dxoverdy/Alpha2MQTT/(threads)

Thread 1 (2022-09-13):

ESP32 support

mercurystorm, 2022-09-13:
I love the idea of this and looking to build my own - Do you know if this would work on an ESP32 instead of an ESP8266?

Benefit being that the ESP32 is much more powerful

dxoverdy, 2022-09-13:
This is a Wemos D1 ESP8266 vs D1 ESP32 circuit layout.
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

Instead of adding
http://arduino.esp8266.com/stable/package_esp8266com_index.json
to your Arduino Board Manager URLs, you'd add
https://dl.espressif.com/dl/package_esp32_index.json

And in Board Manager, search out esp32 to install appropriate libraries for the ESP32 Dev module, WEMOS LoLin32 or WEMOS D1 MINI ESP32.

To get the code to compile will involve changing WiFi8266.h to WiFi.h and SoftwareSerial.h to HardwareSerial.h and utilising pins such as IO18, IO19 and IO23 instead of D5, D6 and D7 respectively, seeing as the ESP32 has more than one hardware based serial port.

Let me source one, I'll tweak the code and either create a fork or see if there is a way to #define it to death.  Unless you fancy being a remote tester with my attempts? :)

mercurystorm, 2022-09-13:
Happy to be a remote tester, I already have an ESP32 lying around in the draw, and have ordered the other parts off amazon, but they will take a day or 3 to arrive (Ireland)

mercurystorm, 2023-04-11:
Just as an update on this - I finally ordered a MAX3485 and decided to play around with the ESP32 to see if I could get it working - If anyone else plans to use an ESP32 these are the changes I made

**Alpha2MQTT.ino**
Changed Line 19
`#include <ESP8266WiFi.h>`

to

`#include <WiFi.h>`

************************************

**Definitions.h**
Added Line 13
`#define LED_BUILTIN 2`

************************************

**RS485Handler.h**
Changed the following pin assignments

`#define SERIAL_COMMUNICATION_CONTROL_PIN D5	// Transmission set pin
#define RX_PIN D6							// Serial Receive pin
#define TX_PIN D7							// Serial Transmit pin`

to

`#define SERIAL_COMMUNICATION_CONTROL_PIN 18	// Transmission set pin
#define RX_PIN 19							// Serial Receive pin
#define TX_PIN 23							// Serial Transmit pin`

Added Package: **ESPSoftwareSerial**

dan-s-github, 2023-06-11:
I ordered a m5stack ATOM RS485 Kit https://shop.m5stack.com/products/atom-rs485-kit and also an atom s3 that includes the display and should look pretty neat and doesn't require an additional power supply.

will try to build and install using the comments above

https://docs.m5stack.com/en/atom/atomic485

RX_PIN 22
TX_PIN 19

dxoverdy, 2023-07-23:
ESP32 support now added.  Please see instructions in 1.21 and 1.22.  With regards, Dan.

Closed 2023-07-23.

Thread 2 (2022-09-27):

Ground?

jt1971, 2022-09-27:
Good morning.  I was delighted to find this having recently taken delivery of a Smile5 inverter.
Just waiting for all the components to arrive to set up as per your excellent notes.
Can I just confirm from the diagram you don't have a ground connection specifically to the RJ45 connector? Not sure which are the ground wires used by the Alpha and my electronics knowledge is not as advanced!

Thanks.

dxoverdy, 2022-09-27:
Ground (as in next to A+/B-) on the MAX3845 isn’t required.  It’s if you
have outer shielding on your cable as opposed to leveraging twisted pair
which is inherently shielded via the twists.

As the Smile is an RJ45 with twisted pair it’s shielded already, and likely
no pin on the Alpha is a ground anyway.

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

jt1971, 2022-10-02:
Thanks.

Al installed and working perfectly on my Smile5 (just waiting batteries).  Can I congratulate you on really clear and helpful instructions, both the code and the wiring. Can I get you a virtual coffee?!

dxoverdy, 2022-10-03:
That's really kind, and I am really glad you went ahead and built it and had success!  I didn't have anything set up by way of ko-fi, it wasn't the main driving force...  But, I have done so and set up the sponsor link to ko-fi on the right hand side of the Alpha2MQTT repository homepage :)  Thanks again.

If you have any pictures of your build in situ with your inverter I've love to see them and put on the gallery.

Finally, could I ask which pins ended up being A+/B- on the Smile 5 for the documentation?

jt1971, 2022-10-18:
Hi there,

Apologies for the delay, but have been waiting for the batteries to be installed before I sent though a picture.

Thanks again,

Justin
￼￼

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

JohnnyZeta, 2022-11-04:
Hi jt1971! I also have a SMILE5 inverter, and I'm struggling to find a ModBus response from the RJ45 plugs on the device.
I tried every couple of wire (white blue/blue, white green/green and so on) on every RJ45 port that seems possible (I tried INV, LAN, CAN), but still no response.

My model is [this one](https://alpha-ess.co.nz/wp-content/uploads/2021/02/Installation-Manual-Storion-Smile-5-V2.pdf).

How do you connected yours?

Thank You in advance!

danielyoung1000, 2022-11-04:
On Page 51 of your manual there, ensure 'Modbus' is enabled on your device.  In the modbus documentation (pic below) it also says "LAN2 or CAN - Modbus must be activated in the display"
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

In effect, it's the most right hand port.

I believe it is the same two pins as my B3 - blue white and blue.  Blue white to +.

dxoverdy, 2022-11-04:
Bah, was signed in with my work account.  Let me know how you get on.

dxoverdy, 2022-11-04:
Any pictures of your working device would be gratefully received.  I'd love to see other people's efforts!

ffrog8, 2022-11-11:
@JohnnyZeta I think I'm having similar issues with my smile5. Could you confirm you inverted RX-TX pair on the D1 - do you mean you switched the D1 mini's pins D6 and D7?

dxoverdy, 2022-11-11:
I suspect @JohnnyZeta put D6 to Rx and D7 to Tx, instead of the other way round.

ffrog8, 2022-11-11:
Ahhh okay. @JohnnyZeta did you have to enable modbus in your inverter settings? I don't even seem to have that setting. Thanks.

JohnnyZeta, 2022-11-11:
Hi @ffrog8!
Yes, I inverted D6 and D7, so that was my error.

I enabled slave modbus mode in the inverter's settings; you should found it under Menu -> Setting (1111 default password) -> Function -> Modbus. I also restarted the inverter, but I don't know if is needed/relevant.

ffrog8, 2022-11-11:
Cheers mate. I dunno if its a firmware difference or set up difference but i have no Modbus (or parallel) option in my Function sub menu. I'm running EMS 1.02.41, BMS 1.02 and Invert version 01.97 - how does that compare to your versions? Set up wise I have the smile 5 with 6.6kw of panels and the 13kwh battery - hybrid i think they call it.

Closed 2022-11-22.

Thread 3 (2022-11-22):

Which register for Alpha5 PV array

jt1971, 2022-11-22:
Hi. I know this will seem a bizarre question, but I cannot actually find the register that relates to the two DC connected PV arrays on my Smile5.

REG_PV_METER_R_TOTAL_ACTIVE_POWER_1 reports values for my AC coupled separate solax inverter through a 2nd ACR10R meter.

The only way which does seem odd, is for me to sum the output of REG_INVERTER_HOME_R_PV1_POWER_1 + REG_INVERTER_HOME_R_PV1_POWER_2 and multiply by 10, which approximates to the instantaneous PV output as displayed on the inverter screen itself.

I'm sure I'm missing something, but having looked through all the registers, I cannot find a register that reflects the PV output from the arrays that are connected directly to the inverter.

Thanks.

SorX14, 2022-11-23:
https://github.com/dxoverdy/Alpha2MQTT/blob/master/Alpha2MQTT/RegisterHandler.cpp#L3102 looks to be dividing by 10 incorrectly, i.e. `REG_INVERTER_HOME_R_PV1_POWER_X` registers are giving values that are 10 times less than what it should be.

Those two registers are for the strings of panels connected to the SMILE5, at least they are for me. They match the readings available from the AlphaESS Cloud dashboard (if you check the XHR requests).

dxoverdy, 2022-11-23:
The registers which consist of a _1 and _2 at the end are in fact the same register but a lower and upper end because the number is potentially so large it needs two registers to store it in its entirety.  In the code I’ve commented out the _2s because reading handled registers (ie what gets spat out in a repeating state) does all the hard work of combining the two in the correct way.  What you added there were the two component parts of one array and multiplied and out of chance it got somewhere near.

You want to expose these in one of your repeating states, presumably the 10 second one:

REG_INVERTER_HOME_R_PV1_POWER_1
REG_INVERTER_HOME_R_PV2_POWER_1
REG_INVERTER_HOME_R_PV3_POWER_1

etc etc.  And add those together to get total DC input.

P.S. what’s the use case?  I understand individuals for plotting charts for east/west arrays for example.

dxoverdy, 2022-11-23:
> https://github.com/dxoverdy/Alpha2MQTT/blob/master/Alpha2MQTT/RegisterHandler.cpp#L3102 looks to be dividing by 10 incorrectly, i.e. `REG_INVERTER_HOME_R_PV1_POWER_X` registers are giving values that are 10 times less than what it should be.
>
> Those two registers are for the strings of panels connected to the SMILE5, at least they are for me. They match the readings available from the AlphaESS Cloud dashboard (if you check the XHR requests).

Noted and correct.  Will modify and upload later.  The joy of copy and pasting!

dxoverdy, 2022-11-23:
Amended to remove the 0.1 mulitplication.  Let us know how you get on summing up the appropriate number of
REG_INVERTER_HOME_R_PV1_POWER_1
REG_INVERTER_HOME_R_PV2_POWER_1
REG_INVERTER_HOME_R_PV3_POWER_1
and if good, close the issue.

Thanks very much
Dan

jt1971, 2022-11-26:
Perfect.  Only just been able to update and test.  Thanks. PV1+PV2 now exactly mirrors the Smile5 display.

Closed 2022-11-26.

Thread 5 (2023-01-07):

Does alphaess support master -slave configuring?

Saadi246, 2023-01-07:
Does alphaess support master and slave?
Please share sum details

dxoverdy, 2023-01-14:
No, the Alpha is a slave device, which can be driven by one master ala Alpha2MQTT or their EV WallBox charger.

Closed 2023-01-14.

Thread 6 (2023-02-28):

Discharge mode

jt1971, 2023-02-28:
Hi. I've been really impressed with the alpha2mqtt, both hardware and the software. I have mine connected to HA and have therefore used your excellent yaml code for the mqtt and the controls.  Everything is working fine other than:
1. With the exception of the charge mode, 'Dispatch mode' always states 'unknown' (the ModBus arduino code is reporting 'unknown'
2. If I try to select discharge mode (to dump excess battery charge into the car for example), although the response status says 'setDischargeStatus' and and '0' for failure detail, the dispatch power does not budge from 32000W and other parameters in the Information entity box remain unchanged.

I'm not entirely sure how I can diagnose further.  HA is sending out the correct mqtt message as far as I can tell (using MQTT explorer on my Mac).

Apologies if a bit of a lame question, but I'm not sure how to progress to resolve this?

Thanks!

ettiennecoetzee, 2024-01-06:
Hi, mine says the same. What inverter do you have?

ettiennecoetzee, 2024-01-08:
My discharge mode on the Smile G3S5 is also not working. I set the target soc and max dc wattage and 2 hour time span, but no discharge. Let me know if I can share specific details so that you can trouble shoot? @dxoverdy

dxoverdy, 2024-01-08:
I’ve no idea what could be causing this as the steps are the same.  But I’m
thinking it may be down to the current regulation set in the system.

Can you read out regulation please and let me know what it is?

On Mon, 8 Jan 2024 at 13:33, Ettienne Coetzee ***@***.***>
wrote:

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

dxoverdy, 2024-01-08:
Read out via handled register 0x1000

#define REG_SAFETY_TEST_RW_GRID_REGULATION 0x1000

I’m wondering if your inverter is set to a grid regulation which doesn’t
currently (or suggests) it doesn’t allow discharge.

Please let me know the return value and description.  Mine for example is
16 / G99

On Mon, 8 Jan 2024 at 15:52, Ettienne Coetzee ***@***.***>
wrote:

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

ettiennecoetzee, 2024-01-08:
Data value: 10
Formatted: NRS097-2-1
Function code:3
Raw data: [0,10]

dxoverdy, 2024-01-08:
Send four separate MQTT messages to this topic:
Alpha2MQTT/request/write/register/raw/data

-- Dispatch Start
`{
    "registerAddress": "0x0880",
    "dataBytes": 2,
    "value": 1
}`

-- Power (1000W discharge)
`{
    "registerAddress": "0x0881",
    "dataBytes": 4,
    "value": 33000
}`

-- Time (Just two 2 minutes)
`{
    "registerAddress": "0x0887",
    "dataBytes": 4,
    "value": 120
}`

-- SOC (down to 15%) 15 / 0.4 = 37.5, so 38 will do
{
    "registerAddress": "0x0886",
    "dataBytes": 2,
    "value": 38
}

-- Mode - SOC Control (2)
`{
    "registerAddress": "0x0885",
    "dataBytes": 2,
    "value": 2
}`

You don't have to rush them.  Allow a few seconds before each, allowing plenty of time for copy and paste.  I am wondering if pinging the four steps required to activate discharge (Start Dispatch, Set Power, Set Duration, Set Minimum SOC and Set Mode) if issued separately works.  If it does that would suggest when Alpha2MQTT sends the messages, it is sending them all too quickly.

ettiennecoetzee, 2024-01-08:
Done. No discharge.

This is what my Alpha Control Dash looks like:
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

dxoverdy, 2024-01-08:
Whoahh that percentage needs a bit of work.  What is your battery
percentage currently (proper) and why is battery power zero?

On Mon, 8 Jan 2024 at 18:20, Ettienne Coetzee ***@***.***>
wrote:

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

dxoverdy, 2024-01-08:
Does the same set of commands, albeit with 31000 power start charging at
1000W?

On Mon, 8 Jan 2024 at 18:20, Ettienne Coetzee ***@***.***>
wrote:

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

ettiennecoetzee, 2024-01-09:
Battery percentage was 90%. I think the power was zero since it wasnt charging or discharging.
I changed the 33000 to 1000. This is what happened:
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

dxoverdy, 2024-01-09:
Any idea why the battery is not either discharging or charging?

On Tue, 9 Jan 2024 at 07:13, Ettienne Coetzee ***@***.***>
wrote:

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

dxoverdy, 2024-01-09:
Either way the percentage reading is unexpected.  Whilst it may not be to
blame it doesn’t fill me with confidence anyway.

If you want to do what others have done, ping me a private message with
details to access your home assistant instance (preferably a separate
account for me so you can disable it after) and I’ll have a Quick Look
around.

On Tue, 9 Jan 2024 at 07:13, Ettienne Coetzee ***@***.***>
wrote:

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

jt1971, 2024-01-09:
As an aside, my target soc has always shown spurious figures but still works great on my Smile5.Sent from my iPhone.On 9 Jan 2024, at 07:27, Daniel Young ***@***.***> wrote:
Either way the percentage reading is unexpected.  Whilst it may not be to

blame it doesn’t fill me with confidence anyway.

If you want to do what others have done, ping me a private message with

details to access your home assistant instance (preferably a separate

account for me so you can disable it after) and I’ll have a Quick Look

around.

On Tue, 9 Jan 2024 at 07:13, Ettienne Coetzee ***@***.***>

wrote:

> But it still won't discharge

>

> —

> Reply to this email directly, view it on GitHub

> <https://github.com/dxoverdy/Alpha2MQTT/issues/6#issuecomment-1882523074>,

> or unsubscribe

> <https://github.com/notifications/unsubscribe-auth/AZC7OYIF52KXQWCCNLG5AFTYNTU2NAVCNFSM6AAAAAAVK5DXOCVHI2DSMVQWIX3LMV43OSLTON2WKQ3PNVWWK3TUHMYTQOBSGUZDGMBXGQ>

> .

> You are receiving this because you were mentioned.Message ID:

> ***@***.***>

>

—Reply to this email directly, view it on GitHub, or unsubscribe.You are receiving this because you authored the thread.Message ID: ***@***.***>

dxoverdy, 2024-01-09:
So it looks like that safety regulation may prevent discharge from battery
to grid.  After all, the code to charge is the same code to discharge, one
just uses a number above 32000 and the other uses one below.  I can see the
other fella in this chat now discharges fine so not sure what he’s done to
get it working….

Perhaps mail alpha and ask if your regulation prevents discharge.

(You can always change it to something we know such as G99 to try)

Good luck!

On Tue, 9 Jan 2024 at 14:06, Ettienne Coetzee ***@***.***>
wrote:

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

ettiennecoetzee, 2024-01-10:
Sorry for bugging you again. Just a quick question. I want to try and set my 0x1000 register to your value (G99). This might be a dumb question, but how do I go about this? When I currently read my raw register, it looks like this:
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
What should I enter in my Alpha Control dash to change it to yours, and also, if I want to change it back?
Thanks!

dxoverdy, 2024-01-10:
Like so:

#define GRID_REGULATION_AL_10 10
#define GRID_REGULATION_AL_10_DESC "NRS097-2-1"
which is why yours currently returns raw data 0,10
#define GRID_REGULATION_AL_16 16
#define GRID_REGULATION_AL_16_DESC "G99"

`Alpha2MQTT/request/write/register/raw/data`

Set to G99
`{
    "registerAddress": "0x1000",
    "dataBytes": 2,
    "value": 16
}`

Set to NRS097-2-1
`{
    "registerAddress": "0x1000",
    "dataBytes": 2,
    "value": 10
}`

Closed 2024-01-22.

Thread 8 (2023-05-15):

Set charge / discharge times?

Spookster, 2023-05-15:
*Havent installed yet
Before I dive in, is there a documented way to set discharge / charge times from the interface via code example? (Home Assistant)
Im running a SMILE5 and the documentation and HA Dashboards youve provided doesnt seem to cover that specifically (although it would be possible)

Does anyone have a HA example? or did I miss it?

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

dxoverdy, 2023-05-15:
The registers here (
https://github.com/dxoverdy/Alpha2MQTT/blob/4966f1f971f7648a23bdbb75225ca94c7a37ab1e/Alpha2MQTT/Definitions.h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)
write those settings.

For example, writing 1 to  REG_TIMING_RW_TIME_CHARGE_START_TIME_1
Will set a start charge time of 00:01.

Alternatively, you can set charge or discharge via an mqtt message.

Dan

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

Spookster, 2023-05-15:
So theres nothing in the Alpha Write Register HA pages that specifically set it? (ie no dashboard pages that people have created specifically for that control?)
Ill delve in deeper once its running
Thanks Dan, your work seems like just what I want.. let the fun begin.....

Spookster, 2023-05-16:
So this would give a time of 0.01?

```
service: mqtt.publish
data:
  retain: false
  topic: Alpha2MQTT/request/write/register/raw/data
  payload:
    registerAddress: "0x0851"
    value: 1
    dataBytes: 2
  qos: "0"
```
And this 2300?
```
service: mqtt.publish
data:
  retain: false
  topic: Alpha2MQTT/request/write/register/raw/data
  payload:
    registerAddress: "0x0851"
    value: 2300
    dataBytes: 2
  qos: "0"
```

dxoverdy, 2023-05-16:
There is a dashboard which lets you specify a register address and a value
and it will write it.  It’s called Alpha Inverter Control or something like
that.

If you read the docs I’m sure the charge discharge times are set as
minutes, so 0 would be midnight, 1439 would be 23:59 (60*23)+59.  Although
they were the first registers I played with when it comes to writing I just
can’t remember.  What I’d do is write 0 and see what happens, then 10, then
60, etc….

Regarding payloads, download mqttexplorer and do your initial testing
through that.  It’s an invaluable tool.

What is your intention here can I ask?

Dan

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

Spookster, 2023-05-16:
Nothing too specific I guess, currently using Charles Gillanders code to switch to mains power to run a heat pump when temperatures drop early morning to preserve the battery for use during the day.
Normally the battery is set to discharge mode, but for that case, run it on mains and then switch back to battery
The only reason I switch to mains is to make use of the power credits I have accumulated :)

Other case use would be for variable 'free hours' various wholesalers offer here. (You can select on a daily basis which hour is free)
I currently get a fixed 3 hrs free between 9pm and 12, so it doesnt really effect mine. Thats the fixed battery charge time.

jt1971, 2023-05-16:
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

My code is scrappy but works well using timed automations to send the mqttt messages using the brilliantly engineered alpha2mqtt work.  Have got it to the point that it works semi-autonomously including managing charge/discharge with/without EV maximising benefit from Octopus Flux tariff.

It is too scrappy to share but happy to share the principles I used in HA?

Spookster, 2023-05-17:
> It is too scrappy to share but happy to share the principles I used in HA?

Id be happy to see what you have done to give some ideas?

DannyBoy-PI, 2023-09-19:
My AlphaESS SMILE B3 can have 15, 30 & 45 minutes set for charge/discharge times. I have modified the Definitions.h, RegisterHandler.cpp and Alpha2MQTT.ino to include the new registry hex values for this, but the values for minutes always report zero. Any ideas as to what may be wrong (I followed the AlphaESS_Register_Parameter_List.pdf and ensured I have set the correct values (0x085E, 0x085F, 0x0860 & 0x0861)) ? Great project and far more reliable than trying to pull data from the Alpha Cloud.
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

spiderdijon, 2024-04-09:
I have also noticed 0x085E, 0x085F, 0x0860 & 0x0861 appear to be always 0 even when set to 15,30,45 minutes in the app. Has anyone managed to set the minute registers successfully?

DannyBoy-PI, 2024-04-09:
No, I haven't been able to get this to work. I contacted AlphaESS and they "claim" it is not supported on the B3. I set the times using the webpage and disconnected my B3 from the net and it charged at the specified time (10:15 -> 10:30 I seem to recall), so it does action the request locally (not a push from AlphaESS), I just have not found out where it is stored in the registry of the B3.....

dxoverdy, 2024-04-09:
They were the first registers I wrote to as a test as they were pretty safe.
I found you could burn any time you wanted:

First Start Time Charge -- 00:30
{"registerAddress": "0x0856","value":30,"dataBytes":2}
First Stop Time Charge -- 04:30
{"registerAddress": "0x0857","value":270,"dataBytes":2}
Second Start Time Charge -- 17:51
{"registerAddress": "0x0858","value":1071,"dataBytes":2}
Second Stop Time Charge -- 18:42
{"registerAddress": "0x0859","value":1122,"dataBytes":2}

Just multiply 60 by the number of hours and add on the remaining minutes.  17:51 and 18:42 will appear on the web site, but I couldn't tell you if the inverter honours is.  Sticking to 15 minutes at the very least will.

DannyBoy-PI, 2024-04-10:
Interesting, I tried to set it for 02:15 (60 x 2 + 15) = 135 using the following:-
mosquitto_pub -h <servername> -p 1883 -t Alpha2MQTT/request/write/register/raw/data -m '{"registerAddress":"0x0856","dataBytes":2,"value":135}'
And it has set the charge start time for 15:00 ? Am I being a bit dim ?

dxoverdy, 2024-04-10:
That’s weird.  That suggests every 1 is worth 6.666 minutes.

What does it change to if you just burn the value 1?

Also, don’t forget, with your alpha2mqtt you can ping a four hour charge
message manually at 2:15 if you are seeking to make use of a car tariff.

Regards
Dan

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

DannyBoy-PI, 2024-04-10:
Hi Dan,
Sending value 1 sets it to 01:00.
As for the reason behind me wanting this: On Intelligent Octopus Go, you get cheap rates during the day (if charging your car) if the weather is windy enough. I'm knocking up code to detect this and then making use of it to charge my Alpha Batts (and change the unit rate in my app) if I need too...
Cheers,
Dan M.

DannyBoy-PI, 2024-04-10:
Even weirder, setting it to 130 changes the start time to 10:00 ????

dxoverdy, 2024-04-10:
I think that makes sense.  If you work on the assumption that 1 is an hour,
5 days is 120 hours and you’re back at midnight.  The remaining 10 gets you
to ten am.

How about 0.25?

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

DannyBoy-PI, 2024-04-10:
sending 0.25 gives me a start time of 01:00

DannyBoy-PI, 2024-04-10:
Interesting, sending 0.50 gives me a start time of 02:00

DannyBoy-PI, 2024-04-10:
and 0.75 gives me 03:00, so I tried 0.80 and I got 08:00 !!, so I tried 1.25 and got 05:00..........

DannyBoy-PI, 2024-05-16:
Hi Dan,
Thanks for the above, but that is what I was originally trying to do before my first post to this group. I will try again though and see if it makes any difference...

DannyBoy-PI, 2024-05-16:
Hi again Dan,
Just tried the following:-

mosquitto_pub -h <server_name> -p 1883 -t Alpha2MQTT/request/write/register/raw/data -m '{"registerAddress":"0x085E","dataBytes":2,"value":25}'

And the value for minutes remains unchanged on the website/app - Do you have a legacy Smile B3 and have you tried the same ?

Cheers,

Dan M.

dxoverdy, 2024-05-16:
I have a B3 basic and Alpha told me it would never support any new features
such as the more granular time, or the discharge to grid via app, or modbus
TCP.

They’ve moved on from it unfortunately, harsh seeing as I dropped 4k on an
11kWh system but times move on.

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

DannyBoy-PI, 2024-05-16:
Hi Dan,

Yeah, it's odd that it supports it via the app/web (i.e. 00,15,30,45 minutes), yet it doesn't use those registers. I've proved it's not a push at the specific time from Alpha as I disconnected my system from the net and it started charging at the time I set.. So... It must be storing it somewhere in the registry, I just don't know where. I was considering knocking up a bit of code to collect all the registry data, then make the change (to say 02:45), collect the all the registry data again, and then check for differences...I will give this a go at some point, but busy with other things right now...

Thanks anyway, your code/hardware does just about everything else I need and is far superior to API's.

It is a shame that Alpha can't be bothered to support the legacy systems that have at least 4 or 5 years of life left to them. It would certainly make me think before purchasing a new Alpha system in the future, which is a shame as the hardware is good !

Dan M.

dxoverdy, 2024-05-16:
You are lucky, my web interface is still 15 min intervals and no discharge
option.

That said, don’t need that shit anyway with Alpha2MQTT

Also, don’t forget, you can use Alpha2MQTT to charge/discharge at any time
you like and for as long as you like, replicating the web interface.

But I will still keep trying with the web interface.
Dan

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

Thread 9 (2023-05-18):

Home Assistant Errors

mercurystorm, 2023-05-18:
For the past few days a few of my displays have shown "Unknown"

A bit of googling it seems something changed / broke with 2023.5 - I just found your updated configuration.yml and applied id.. but still getting errors

May need to remove state_class from the 24 entities with enum?

Entity sensor.alpha_read_raw_register_register_address (<class 'homeassistant.components.mqtt.sensor.MqttSensor'>) is using state class 'measurement' which is impossible considering device class ('enum') it is using; expected None; Please update your configuration if your entity is manually configured, otherwise create a bug report at https://github.com/home-assistant/core/issues?q=is%3Aopen+is%3Aissue+label%3A%22integration%3A+mqtt%22
Entity sensor.alpha_read_raw_register_raw_data (<class 'homeassistant.components.mqtt.sensor.MqttSensor'>) is using state class 'measurement' which is impossible considering device class ('enum') it is using; expected None; Please update your configuration if your entity is manually configured, otherwise create a bug report at https://github.com/home-assistant/core/issues?q=is%3Aopen+is%3Aissue+label%3A%22integration%3A+mqtt%22
Entity sensor.alpha_write_raw_data_register_response_status (<class 'homeassistant.components.mqtt.sensor.MqttSensor'>) is using state class 'measurement' which is impossible considering device class ('enum') it is using; expected None; Please update your configuration if your entity is manually configured, otherwise create a bug report at https://github.com/home-assistant/core/issues?q=is%3Aopen+is%3Aissue+label%3A%22integration%3A+mqtt%22
Entity sensor.alpha_write_raw_data_register_register_address (<class 'homeassistant.components.mqtt.sensor.MqttSensor'>) is using state class 'measurement' which is impossible considering device class ('enum') it is using; expected None; Please update your configuration if your entity is manually configured, otherwise create a bug report at https://github.com/home-assistant/core/issues?q=is%3Aopen+is%3Aissue+label%3A%22integration%3A+mqtt%22
Entity sensor.alpha_write_raw_data_register_raw_data (<class 'homeassistant.components.mqtt.sensor.MqttSensor'>) is using state class 'measurement' which is impossible considering device class ('enum') it is using; expected None; Please update your configuration if your entity is manually configured, otherwise create a bug report at https://github.com/home-assistant/core/issues?q=is%3Aopen+is%3Aissue+label%3A%22integration%3A+mqtt%22

Spookster, 2023-05-24:
@mercurystorm
did you manage to get the right format for this?

mercurystorm, 2023-05-27:
I do mine slightly different as I dont replace the configuration file - in my configuration file I have:

homeassistant:
    packages:
      pack_1: !include alphaess.yaml

and in my alphaess.yaml i have:

#MQTT
mqtt:
  button:
# Inverter Buttons
    - unique_id: alpha_set_normal
      command_topic: "Alpha2MQTT/request/set/normal"
      name: "Alpha Set Normal"
      command_template: "{\"void\": 0}"
      payload_press: "true"
      qos: 0
      retain: false
      entity_category: "config"
      icon: "mdi:lightbulb-auto"

    - unique_id: alpha_set_charge
      command_topic: "Alpha2MQTT/request/set/charge"
      name: "Alpha Set Charge"
      command_template: "{\"watts\": {{ states('input_number.input_dispatch_charge_watts')|int }},\"socPercent\": {{ states('input_number.input_dispatch_charge_soc')|int }},\"duration\": {{ states('input_number.input_dispatch_charge_time')|int }} }"
      qos: 0
      retain: false
      entity_category: "config"
      icon: "mdi:battery-positive"

    - unique_id: alpha_set_discharge
      command_topic: "Alpha2MQTT/request/set/discharge"
      name: "Alpha Set Discharge"
      command_template: "{\"watts\": {{ states('input_number.input_dispatch_discharge_watts')|int }},\"socPercent\": {{ states('input_number.input_dispatch_discharge_soc')|int }},\"duration\": {{ states('input_number.input_dispatch_discharge_time')|int }} }"
      qos: 0
      retain: false
      entity_category: "config"
      icon: "mdi:battery-negative"

    - unique_id: alpha_read_handled_register
      command_topic: "Alpha2MQTT/request/read/register/handled"
      name: "Alpha Read Handled Register"
      command_template: "{\"registerAddress\": \"{{ states('input_text.input_read_handled_register_register_address') }}\" }"
      qos: 0
      retain: false
      entity_category: "config"
      icon: "mdi:database-export"

    - unique_id: alpha_read_raw_register
      command_topic: "Alpha2MQTT/request/read/register/raw"
      name: "Alpha Read Raw Register"
      command_template: "{\"registerAddress\": \"{{ states('input_text.input_read_raw_register_register_address') }}\", dataBytes: {{ states('input_number.input_read_raw_register_data_bytes')|int }} }"
      qos: 0
      retain: false
      entity_category: "config"
      icon: "mdi:database-export"

    - unique_id: alpha_write_raw_data_register
      command_topic: "Alpha2MQTT/request/write/register/raw/data"
      name: "Alpha Write Raw Data Register"
      command_template: "{\"registerAddress\": \"{{ states('input_text.input_write_raw_data_register_register_address') }}\", dataBytes: {{ states('input_number.input_write_raw_data_register_data_bytes')|int }}, value: {{ states('input_number.input_write_raw_data_register_value')|int }} }"
      qos: 0
      retain: false
      entity_category: "config"
      icon: "mdi:database-export"

#MQTT Sensors
  sensor:
#Inverter Sensors

    - device_class: "battery"
      state_class: "measurement"
      force_update: "true"
      icon: "mdi:battery"
      name: "Alpha Battery SOC"
      unique_id: "alpha_battery_soc"
      unit_of_measurement: "%"
      state_topic: "HomeAssistant/MQTTSensor/REG_BATTERY_HOME_R_SOC"
      value_template: "{{ value | int }}"

    - device_class: "power"
      state_class: "measurement"
      force_update: "true"
      icon: "mdi:battery-charging-100"
      name: "Alpha Battery Power"
      unique_id: "alpha_battery_power"
      unit_of_measurement: "W"
      state_topic: "HomeAssistant/MQTTSensor/REG_BATTERY_HOME_R_BATTERY_POWER"
      value_template: "{{ value | int }}"

    - device_class: "power"
      state_class: "measurement"
      force_update: "true"
      icon: "mdi:battery-charging"
      name: "Alpha Battery Power Absolute"
      unique_id: "alpha_battery_power_absolute"
      unit_of_measurement: "W"
      state_topic: "HomeAssistant/MQTTSensor/REG_BATTERY_HOME_R_BATTERY_POWER_ABSOLUTE"
      value_template: "{{ value | int }}"

    - device_class: "power"
      state_class: "measurement"
      force_update: "true"
      icon: "mdi:battery-arrow-up"
      name: "Alpha Battery Power Charging"
      unique_id: "alpha_battery_power_charging"
      unit_of_measurement: "W"
      state_topic: "HomeAssistant/MQTTSensor/REG_BATTERY_HOME_R_BATTERY_POWER_CHARGING"
      value_template: "{{ value | int }}"

    - device_class: "power"
      state_class: "measurement"
      force_update: "true"
      icon: "mdi:battery-arrow-down"
      name: "Alpha Battery Power Discharging"
      unique_id: "alpha_battery_power_discharging"
      unit_of_measurement: "W"
      state_topic: "HomeAssistant/MQTTSensor/REG_BATTERY_HOME_R_BATTERY_POWER_DISCHARGING"
      value_template: "{{ value | int }}"

    - device_class: "power"
      state_class: "measurement"
      force_update: "true"
      icon: "mdi:transmission-tower"
      name: "Alpha Grid Power"
      unique_id: "alpha_grid_power"
      unit_of_measurement: "W"
      state_topic: "HomeAssistant/MQTTSensor/REG_GRID_METER_R_TOTAL_ACTIVE_POWER_1"
      value_template: "{{ value | int }}"

    - device_class: "power"
      state_class: "measurement"
      force_update: "true"
      icon: "mdi:transmission-tower"
      name: "Alpha Grid Power Absolute"
      unique_id: "alpha_grid_power_absolute"
      unit_of_measurement: "W"
      state_topic: "HomeAssistant/MQTTSensor/REG_GRID_METER_R_TOTAL_ACTIVE_POWER_1_ABSOLUTE"
      value_template: "{{ value | int }}"

    - device_class: "power"
      state_class: "measurement"
      force_update: "true"
      icon: "mdi:transmission-tower-export"
      name: "Alpha Grid Power Exporting"
      unique_id: "alpha_grid_power_exporting"
      unit_of_measurement: "W"
      state_topic: "HomeAssistant/MQTTSensor/REG_GRID_METER_R_TOTAL_ACTIVE_POWER_1_EXPORTING"
      value_template: "{{ value | int }}"

    - device_class: "power"
      state_class: "measurement"
      force_update: "true"
      icon: "mdi:transmission-tower-import"
      name: "Alpha Grid Power Importing"
      unique_id: "alpha_grid_power_importing"
      unit_of_measurement: "W"
      state_topic: "HomeAssistant/MQTTSensor/REG_GRID_METER_R_TOTAL_ACTIVE_POWER_1_IMPORTING"
      value_template: "{{ value | int }}"

    - device_class: "current"
      state_class: "measurement"
      force_update: "true"
      icon: "mdi:alpha-a"
      name: "Alpha Grid Current"
      unique_id: "alpha_grid_current"
      unit_of_measurement: "A"
      state_topic: "HomeAssistant/MQTTSensor/REG_CUSTOM_GRID_CURRENT_A_PHASE"
      value_template: "{{ value | float }}"

    - device_class: "power"
      state_class: "measurement"
      force_update: "true"
      icon: "mdi:home-import-outline"
      name: "Alpha Load"
      unique_id: "alpha_load"
      unit_of_measurement: "W"
      state_topic: "HomeAssistant/MQTTSensor/REG_CUSTOM_LOAD"
      value_template: "{{ value | int }}"

    - force_update: "true"
      icon: "mdi:transmission-tower"
      name: "Alpha Grid Status"
      unique_id: "alpha_grid_status"
      state_topic: "HomeAssistant/MQTTSensor/GRID_STATUS"
      value_template: "{{ value | string }}"
      device_class: "enum"

    - force_update: "true"
      icon: "mdi:battery-unknown"
      name: "Alpha Battery Status"
      unique_id: "alpha_battery_status"
      state_topic: "HomeAssistant/MQTTSensor/BATTERY_STATUS"
      value_template: "{{ value | string }}"
      device_class: "enum"

    - device_class: "voltage"
      state_class: "measurement"
      force_update: "true"
      icon: "mdi:alpha-v"
      name: "Alpha Battery Voltage"
      unique_id: "alpha_battery_voltage"
      unit_of_measurement: "V"
      state_topic: "HomeAssistant/MQTTSensor/REG_BATTERY_HOME_R_VOLTAGE"
      value_template: "{{ value | float }}"

    - device_class: "current"
      state_class: "measurement"
      force_update: "true"
      icon: "mdi:alpha-a"
      name: "Alpha Battery Current"
      unique_id: "alpha_battery_current"
      unit_of_measurement: "A"
      state_topic: "HomeAssistant/MQTTSensor/REG_BATTERY_HOME_R_CURRENT"
      value_template: "{{ value | float }}"

    - device_class: "temperature"
      state_class: "measurement"
      force_update: "true"
      icon: "mdi:thermometer"
      name: "Alpha Battery Temperature"
      unique_id: "alpha_battery_temperature"
      unit_of_measurement: "°C"
      state_topic: "HomeAssistant/MQTTSensor/REG_BATTERY_HOME_R_MAX_CELL_TEMPERATURE"
      value_template: "{{ value | float }}"

    - device_class: "power"
      state_class: "measurement"
      force_update: "true"
      icon: "mdi:solar-power"
      name: "Alpha Solar Power"
      unique_id: "alpha_solar_power"
      unit_of_measurement: "W"
      state_topic: "HomeAssistant/MQTTSensor/REG_CUSTOM_TOTAL_SOLAR_POWER"
      value_template: "{{ value | int }}"

    - device_class: "current"
      state_class: "measurement"
      force_update: "true"
      icon: "mdi:alpha-a"
      name: "Alpha Inverter Current"
      unique_id: "alpha_inverter_current"
      unit_of_measurement: "A"
      state_topic: "HomeAssistant/MQTTSensor/REG_INVERTER_HOME_R_CURRENT_L1"
      value_template: "{{ value | float }}"

    - device_class: "temperature"
      state_class: "measurement"
      force_update: "true"
      icon: "mdi:thermometer"
      name: "Alpha Inverter Temperature"
      unique_id: "alpha_inverter_temperature"
      unit_of_measurement: "°C"
      state_topic: "HomeAssistant/MQTTSensor/REG_INVERTER_HOME_R_INVERTER_TEMP"
      value_template: "{{ value | float }}"

    - device_class: "power"
      state_class: "measurement"
      force_update: "true"
      icon: "mdi:meter-electric-outline"
      name: "Alpha Inverter Power"
      unique_id: "alpha_inverter_power"
      unit_of_measurement: "W"
      state_topic: "HomeAssistant/MQTTSensor/REG_INVERTER_HOME_R_POWER_L1_1"
      value_template: "{{ value | int }}"

    - device_class: "voltage"
      state_class: "measurement"
      force_update: "true"
      icon: "mdi:alpha-v"
      name: "Alpha Grid Voltage"
      unique_id: "alpha_grid_voltage"
      unit_of_measurement: "V"
      state_topic: "HomeAssistant/MQTTSensor/REG_GRID_METER_R_VOLTAGE_OF_A_PHASE"
      value_template: "{{ value | float }}"

    - device_class: "voltage"
      state_class: "measurement"
      force_update: "true"
      icon: "mdi:alpha-v"
      name: "Alpha Solar Voltage"
      unique_id: "alpha_solar_voltage"
      unit_of_measurement: "V"
      state_topic: "HomeAssistant/MQTTSensor/REG_PV_METER_R_VOLTAGE_OF_A_PHASE"
      value_template: "{{ value | float }}"

    - device_class: "voltage"
      state_class: "measurement"
      force_update: "true"
      icon: "mdi:alpha-v"
      name: "Alpha Inverter Voltage"
      unique_id: "alpha_inverter_voltage"
      unit_of_measurement: "V"
      state_topic: "HomeAssistant/MQTTSensor/REG_INVERTER_HOME_R_VOLTAGE_L1"
      value_template: "{{ value | float }}"

    - force_update: "true"
      icon: "mdi:information-variant"
      name: "Alpha Dispatch Start"
      unique_id: "alpha_dispatch_start"
      state_topic: "HomeAssistant/MQTTSensor/REG_DISPATCH_RW_DISPATCH_START"
      value_template: "{{ value | string }}"
      device_class: "enum"

    - force_update: "true"
      icon: "mdi:information-variant"
      name: "Alpha Dispatch Mode"
      unique_id: "alpha_dispatch_mode"
      state_topic: "HomeAssistant/MQTTSensor/REG_DISPATCH_RW_DISPATCH_MODE"
      value_template: "{{ value | string }}"
      device_class: "enum"

    - device_class: "battery"
      state_class: "measurement"
      force_update: "true"
      icon: "mdi:battery"
      name: "Alpha Dispatch SOC"
      unique_id: "alpha_dispatch_soc"
      unit_of_measurement: "%"
      state_topic: "HomeAssistant/MQTTSensor/REG_DISPATCH_RW_DISPATCH_SOC"
      value_template: "{{ value | int }}"

    - device_class: "power"
      state_class: "measurement"
      force_update: "true"
      icon: "mdi:battery-charging-100"
      name: "Alpha Dispatch Power"
      unique_id: "alpha_dispatch_power"
      unit_of_measurement: "W"
      state_topic: "HomeAssistant/MQTTSensor/REG_DISPATCH_RW_ACTIVE_POWER_1"
      value_template: "{{ value | int }}"

    - state_class: "measurement"
      force_update: "true"
      icon: "mdi:clock-out"
      name: "Alpha Dispatch Time"
      unique_id: "alpha_dispatch_time"
      unit_of_measurement: "s"
      state_topic: "HomeAssistant/MQTTSensor/REG_DISPATCH_RW_DISPATCH_TIME_1"
      value_template: "{{ value | int }}"

    - device_class: "frequency"
      state_class: "measurement"
      force_update: "true"
      icon: "mdi:sine-wave"
      name: "Alpha Grid Frequency"
      unique_id: "alpha_grid_frequency"
      unit_of_measurement: "Hz"
      state_topic: "HomeAssistant/MQTTSensor/REG_GRID_METER_R_FREQUENCY"
      value_template: "{{ value | float }}"

    - device_class: "frequency"
      state_class: "measurement"
      force_update: "true"
      icon: "mdi:sine-wave"
      name: "Alpha Solar Frequency"
      unique_id: "alpha_solar_frequency"
      unit_of_measurement: "Hz"
      state_topic: "HomeAssistant/MQTTSensor/REG_PV_METER_R_FREQUENCY"
      value_template: "{{ value | float }}"

    - device_class: "frequency"
      state_class: "measurement"
      force_update: "true"
      icon: "mdi:sine-wave"
      name: "Alpha Inverter Frequency"
      unique_id: "alpha_inverter_frequency"
      unit_of_measurement: "Hz"
      state_topic: "HomeAssistant/MQTTSensor/REG_INVERTER_HOME_R_FREQUENCY"
      value_template: "{{ value | float }}"

    - force_update: "true"
      icon: "mdi:information-variant"
      name: "Alpha System Fault"
      unique_id: "alpha_system_fault"
      state_topic: "HomeAssistant/MQTTSensor/REG_SYSTEM_OP_R_SYSTEM_FAULT_1"
      value_template: "{{ value | string }}"
      device_class: "enum"

    - force_update: "true"
      icon: "mdi:information-variant"
      name: "Alpha Battery Fault"
      unique_id: "alpha_battery_fault"
      state_topic: "HomeAssistant/MQTTSensor/REG_BATTERY_HOME_R_BATTERY_FAULT_1"
      value_template: "{{ value | string }}"
      device_class: "enum"

    - device_class: "energy"
      state_class: "measurement"
      force_update: "true"
      icon: "mdi:battery-plus"
      name: "Alpha Battery Total Charge Energy"
      unique_id: "alpha_battery_total_charge_energy"
      unit_of_measurement: "kWh"
      state_topic: "HomeAssistant/MQTTSensor/REG_BATTERY_HOME_R_BATTERY_CHARGE_ENERGY_1"
      value_template: "{{ value | int }}"

    - device_class: "energy"
      state_class: "measurement"
      force_update: "true"
      icon: "mdi:battery-minus"
      name: "Alpha Battery Total Discharge Energy"
      unique_id: "alpha_battery_total_discharge_energy"
      unit_of_measurement: "kWh"
      state_topic: "HomeAssistant/MQTTSensor/REG_BATTERY_HOME_R_BATTERY_DISCHARGE_ENERGY_1"
      value_template: "{{ value | int }}"

    - device_class: "energy"
      state_class: "measurement"
      force_update: "true"
      icon: "mdi:power-plug-battery"
      name: "Alpha Battery Total Charge Energy From Grid"
      unique_id: "alpha_battery_total_charge_energy_from_grid"
      unit_of_measurement: "kWh"
      state_topic: "HomeAssistant/MQTTSensor/REG_BATTERY_HOME_R_BATTERY_ENERGY_CHARGE_FROM_GRID_1"
      value_template: "{{ value | int }}"

    - device_class: "energy"
      state_class: "measurement"
      force_update: "true"
      icon: "mdi:solar-power-variant-outline"
      name: "Alpha System Total Solar Energy"
      unique_id: "alpha_system_total_solar_energy"
      unit_of_measurement: "kWh"
      state_topic: "HomeAssistant/MQTTSensor/REG_SYSTEM_OP_R_SYSTEM_TOTAL_PV_ENERGY_1"
      value_template: "{{ value | int }}"

    - device_class: "energy"
      state_class: "measurement"
      force_update: "true"
      icon: "mdi:transmission-tower-export"
      name: "Alpha System Total Energy Exported To Grid"
      unique_id: "alpha_system_total_energy_exported_to_grid"
      unit_of_measurement: "kWh"
      state_topic: "HomeAssistant/MQTTSensor/REG_GRID_METER_R_TOTAL_ENERGY_FEED_TO_GRID_1"
      value_template: "{{ value | int }}"

    - device_class: "energy"
      state_class: "measurement"
      force_update: "true"
      icon: "mdi:transmission-tower-import"
      name: "Alpha System Total Energy Imported From Grid"
      unique_id: "alpha_system_total_energy_imported_from_grid"
      unit_of_measurement: "kWh"
      state_topic: "HomeAssistant/MQTTSensor/REG_GRID_METER_R_TOTAL_ENERGY_CONSUMED_FROM_GRID_1"
      value_template: "{{ value | int }}"

    - force_update: "true"
      icon: "mdi:information-variant"
      name: "Alpha Dispatch Charge Response Status"
      unique_id: "alpha_dispatch_charge_response_status"
      state_topic: "HomeAssistant/MQTTSensor/CHARGE_RESPONSE_responseStatus"
      value_template: "{{ value | string }}"
      device_class: "enum"

    - force_update: "true"
      icon: "mdi:information-variant"
      name: "Alpha Dispatch Charge Failure Detail"
      unique_id: "alpha_dispatch_charge_failure_detail"
      state_topic: "HomeAssistant/MQTTSensor/CHARGE_RESPONSE_failureDetail"
      value_template: "{{ value | string }}"
      device_class: "enum"

    - force_update: "true"
      icon: "mdi:information-variant"
      name: "Alpha Dispatch Normal Response Status"
      unique_id: "alpha_dispatch_normal_response_status"
      state_topic: "HomeAssistant/MQTTSensor/NORMAL_RESPONSE_responseStatus"
      value_template: "{{ value | string }}"
      device_class: "enum"

    - force_update: "true"
      icon: "mdi:information-variant"
      name: "Alpha Dispatch Normal Failure Detail"
      unique_id: "alpha_dispatch_normal_failure_detail"
      state_topic: "HomeAssistant/MQTTSensor/NORMAL_RESPONSE_failureDetail"
      value_template: "{{ value | string }}"
      device_class: "enum"

    - force_update: "true"
      icon: "mdi:information-variant"
      name: "Alpha Dispatch Discharge Response Status"
      unique_id: "alpha_dispatch_discharge_response_status"
      state_topic: "HomeAssistant/MQTTSensor/DISCHARGE_RESPONSE_responseStatus"
      value_template: "{{ value | string }}"
      device_class: "enum"

    - force_update: "true"
      icon: "mdi:information-variant"
      name: "Alpha Dispatch Discharge Failure Detail"
      unique_id: "alpha_dispatch_discharge_failure_detail"
      state_topic: "HomeAssistant/MQTTSensor/DISCHARGE_RESPONSE_failureDetail"
      value_template: "{{ value | string }}"
      device_class: "enum"

    - force_update: "true"
      icon: "mdi:information-variant"
      name: "Alpha Read Handled Register Response Status"
      unique_id: "alpha_read_handled_register_response_status"
      state_topic: "HomeAssistant/MQTTSensor/READHANDLED_RESPONSE_responseStatus"
      value_template: "{{ value | string }}"
      device_class: "enum"

    - force_update: "true"
      icon: "mdi:information-variant"
      name: "Alpha Read Handled Register Register Address"
      unique_id: "alpha_read_handled_register_register_address"
      state_topic: "HomeAssistant/MQTTSensor/READHANDLED_RESPONSE_registerAddress"
      value_template: "{{ value | string }}"
      device_class: "enum"

    - force_update: "true"
      icon: "mdi:information-variant"
      name: "Alpha Read Handled Register Function Code"
      unique_id: "alpha_read_handled_register_function_code"
      state_topic: "HomeAssistant/MQTTSensor/READHANDLED_RESPONSE_functionCode"
      value_template: "{{ value | int }}"

    - force_update: "true"
      icon: "mdi:information-variant"
      name: "Alpha Read Handled Register Register Name"
      unique_id: "alpha_read_handled_register_register_name"
      state_topic: "HomeAssistant/MQTTSensor/READHANDLED_RESPONSE_registerName"
      value_template: "{{ value | string }}"
      device_class: "enum"

    - force_update: "true"
      icon: "mdi:information-variant"
      name: "Alpha Read Handled Register Data Type"
      unique_id: "alpha_read_handled_register_data_type"
      state_topic: "HomeAssistant/MQTTSensor/READHANDLED_RESPONSE_dataType"
      value_template: "{{ value | string }}"
      device_class: "enum"

    - state_class: "measurement"
      force_update: "true"
      icon: "mdi:information-variant"
      name: "Alpha Read Handled Register Data Value"
      unique_id: "alpha_read_handled_register_data_value"
      state_topic: "HomeAssistant/MQTTSensor/READHANDLED_RESPONSE_dataValue"
      value_template: "{{ value | int }}"

    - force_update: "true"
      icon: "mdi:information-variant"
      name: "Alpha Read Handled Register Formatted Data Value"
      unique_id: "alpha_read_handled_register_formatted_data_value"
      state_topic: "HomeAssistant/MQTTSensor/READHANDLED_RESPONSE_formattedDataValue"
      value_template: "{{ value | string }}"
      device_class: "enum"

    - state_class: "measurement"
      force_update: "true"
      icon: "mdi:information-variant"
      name: "Alpha Read Handled Register Raw Data Size"
      unique_id: "alpha_read_handled_register_raw_data_size"
      state_topic: "HomeAssistant/MQTTSensor/READHANDLED_RESPONSE_rawDataSize"
      value_template: "{{ value | int }}"

    - force_update: "true"
      icon: "mdi:information-variant"
      name: "Alpha Read Handled Register Raw Data"
      unique_id: "alpha_read_handled_register_raw_data"
      state_topic: "HomeAssistant/MQTTSensor/READHANDLED_RESPONSE_rawData"
      value_template: "{{ value | string }}"
      device_class: "enum"

    - force_update: "true"
      icon: "mdi:information-variant"
      name: "Alpha Read Raw Register Response Status"
      unique_id: "alpha_read_raw_register_response_status"
      state_topic: "HomeAssistant/MQTTSensor/READRAW_RESPONSE_responseStatus"
      value_template: "{{ value | string }}"
      device_class: "enum"

    - force_update: "true"
      icon: "mdi:information-variant"
      name: "Alpha Read Raw Register Register Address"
      unique_id: "alpha_read_raw_register_register_address"
      state_topic: "HomeAssistant/MQTTSensor/READRAW_RESPONSE_registerAddress"
      value_template: "{{ value | string }}"
      device_class: "enum"

    - state_class: "measurement"
      force_update: "true"
      icon: "mdi:information-variant"
      name: "Alpha Read Raw Register Function Code"
      unique_id: "alpha_read_raw_register_function_code"
      state_topic: "HomeAssistant/MQTTSensor/READRAW_RESPONSE_functionCode"
      value_template: "{{ value | int }}"

    - state_class: "measurement"
      force_update: "true"
      icon: "mdi:information-variant"
      name: "Alpha Read Raw Register Raw Data Size"
      unique_id: "alpha_read_raw_register_raw_data_size"
      state_topic: "HomeAssistant/MQTTSensor/READRAW_RESPONSE_rawDataSize"
      value_template: "{{ value | int }}"

    - force_update: "true"
      icon: "mdi:information-variant"
      name: "Alpha Read Raw Register Raw Data"
      unique_id: "alpha_read_raw_register_raw_data"
      state_topic: "HomeAssistant/MQTTSensor/READRAW_RESPONSE_rawData"
      value_template: "{{ value | string }}"
      device_class: "enum"

    - force_update: "true"
      icon: "mdi:information-variant"
      name: "Alpha Write Raw Data Register Response Status"
      unique_id: "alpha_write_raw_data_register_response_status"
      state_topic: "HomeAssistant/MQTTSensor/WRITERAW_RESPONSE_responseStatus"
      value_template: "{{ value | string }}"
      device_class: "enum"

    - force_update: "true"
      icon: "mdi:information-variant"
      name: "Alpha Write Raw Data Register Register Address"
      unique_id: "alpha_write_raw_data_register_register_address"
      state_topic: "HomeAssistant/MQTTSensor/WRITERAW_RESPONSE_registerAddress"
      value_template: "{{ value | string }}"
      device_class: "enum"

    - state_class: "measurement"
      force_update: "true"
      icon: "mdi:information-variant"
      name: "Alpha Write Raw Data Register Function Code"
      unique_id: "alpha_write_raw_data_register_function_code"
      state_topic: "HomeAssistant/MQTTSensor/WRITERAW_RESPONSE_functionCode"
      value_template: "{{ value | int }}"

    - state_class: "measurement"
      force_update: "true"
      icon: "mdi:information-variant"
      name: "Alpha Write Raw Data Register Raw Data Size"
      unique_id: "alpha_write_raw_data_register_raw_data_size"
      state_topic: "HomeAssistant/MQTTSensor/WRITERAW_RESPONSE_rawDataSize"
      value_template: "{{ value | int }}"

    - force_update: "true"
      icon: "mdi:information-variant"
      name: "Alpha Write Raw Data Register Raw Data"
      unique_id: "alpha_write_raw_data_register_raw_data"
      state_topic: "HomeAssistant/MQTTSensor/WRITERAW_RESPONSE_rawData"
      value_template: "{{ value | string }}"
      device_class: "enum"

#Sensors
sensor:
#Inverter Helpers
  - platform: integration
    method: trapezoidal
    unit_time: h
    unit_prefix: k
    source: sensor.alpha_battery_power_charging
    name: "Alpha REIMANN Battery Power Charging"
    unique_id: "alpha_reimann_battery_power_charging"
    round: 2

  - platform: integration
    method: trapezoidal
    unit_time: h
    unit_prefix: k
    source: sensor.alpha_battery_power_discharging
    name: "Alpha REIMANN Battery Power Discharging"
    unique_id: "alpha_reimann_battery_power_discharging"
    round: 2

  - platform: integration
    method: trapezoidal
    unit_time: h
    unit_prefix: k
    source: sensor.alpha_grid_power_exporting
    name: "Alpha REIMANN Grid Power Exporting"
    unique_id: "alpha_reimann_grid_power_exporting"
    round: 2

  - platform: integration
    method: trapezoidal
    unit_time: h
    unit_prefix: k
    source: sensor.alpha_grid_power_importing
    name: "Alpha REIMANN Grid Power Importing"
    unique_id: "alpha_reimann_grid_power_importing"
    round: 2

  - platform: integration
    method: trapezoidal
    unit_time: h
    unit_prefix: k
    source: sensor.alpha_load
    name: "Alpha REIMANN Load"
    unique_id: "alpha_reimann_load"
    round: 2

  - platform: integration
    method: trapezoidal
    unit_time: h
    unit_prefix: k
    source: sensor.alpha_solar_power
    name: "Alpha REIMANN Solar Power"
    unique_id: "alpha_reimann_solar_power"
    round: 2

#Inverter Utility Meters
utility_meter:
# Daily
  alpha_utility_meter_daily_battery_power_charge:
    source: sensor.alpha_reimann_battery_power_charging
    cycle: daily
    name: "Alpha UTILITY METER Daily Total Battery Charge"
    unique_id: "alpha_utility_meter_daily_battery_power_charge"
    offset: 0
    delta_values: false

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

Thread 10 (2023-05-20):

Slave or Master?

Spookster, 2023-05-20:
Hey, just trying to work through connection issues for a new build on a smile5.
Definitions set to :
#define INVERTER_SMILE5
I have a working wemos mini and max3485, software loaded, it connects to wireless etc
Display shows A2M *WM

Currently I have a bad crc UR/HB and Im trying to trouble shoot it.

Like you, I have blue + blue/white providing 4v, other wires nothing.
Ive swapped these 2 around, and it doesnt start with blue connected to A

When I checked the Alpha unit, MODBUS was off. Ive turned it on.
Theres also an option for master / slave.
Ive tried both, but assume I would use slave.

You also suggest :
`Make sure the Slave IDs match. Alpha systems use 0x55 by default but if you have changed it on an inverter with an on device interface, change the appropriate line in Definitions.h as documented above.`

I havent changed anything, but how would I check this value if required?

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
D4 and D5 leds flash on the 385

There is continuity between all connections (as much as I can tell)

Any words of wisdom? Thanks!

dxoverdy, 2023-05-20:
Frustrating I can imagine!  Some points:

Blue white definitely A.

The Alpha should be a slave.  For some reason I thought the address could
be changed in the on display settings.

Can you check continuity between pins in both yellow circles? And for A and
B at this point have you got 4V?

Can you check for continuity between pins 6 and 7 on the D1 and ensure that
7 is RX

There is a little script called slave address finder which will cycle
through every possible slave address and return on the screen or mqtt the
slave address, but that definitely assumes no hardware issues first!

If you can send more pics of the entire soldering/wiring setup that will
help, as will a video of the 3845 flashing in dim light up close 👍

Regards
Dan

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

dxoverdy, 2023-05-20:
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

bah, email attachments don’t work

Spookster, 2023-05-20:
`Blue white definitely A. `
Yes

`The Alpha should be a slave. `
Yes, it is set

`Can you check continuity between pins in both yellow circles? `
The 4 pin holes and wiring back to the d1 have continuity, as do the a/b terminals
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
(pardon the tack soldering ; )

`And for A and B at this point have you got 4V? `
Yes, it varies between 3.6-4.3

`Can you check for continuity between pins 6 and 7 on the D1 and ensure that 7 is RX `
There is continuity and using MISO(6) MOSI(7) and 3v3

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

dxoverdy, 2023-05-20:
If both leds are flashing on the 3485 then let’s think out loud…

Only one LED should flash at a time, both flashing at the same time would
indicate a short between mosi and miso but if the flashes are alternate
that indicates your alpha is getting the request, processing it and sending
something back but for some reason it’s not getting it’s way back to the RX
(d7/mosi) on the d1 mini.

It can be confusing but when the d1 mini transmits, the RX led on the 3485
will flash, when the 3485 is sending the result back to the d1 mini the tx
pin will flash, so in effect the LEDs refer to the TTL side, not the rs485
side.

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

dxoverdy, 2023-05-20:
Flashing behaviour vids I’ve just uploaded for reference.  Although it’s hard to discern, the rx tx LEDs alternate quickly because tx and rx aren’t concurrent.

https://youtu.be/vr_lAvNwqhU

https://youtu.be/SKvm9r_2P_U

Spookster, 2023-05-20:
I'll have another look in the morning, but fairly confident they are flashing independently , so I guess theres still possibly some disconnect between the d1 and the 485 but obviously connected to data

dxoverdy, 2023-05-20:
That's it... if flashing independently I think you can be quite confident
that a message is getting out, that the Alpha is processing it and sending
back... and there's just a bit of an issue with the RX element.  If nothing
comes back from the Inverter (ala no flash) then it's open to a whole host
of reasons why.  The Alpha system just doesn't respond if a message is
incorrect, which is irritating because it's no different to when unplugged
which makes debugging.... interesting nonetheless.

Sleep well.

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

Spookster, 2023-05-20:
Heres a startup vid. Swapped back to a breadboard and different D1, same result it seems. Hmmmm
https://youtu.be/IcMiEl4qNeI

Spookster, 2023-05-20:
And with D7 disconnected :
https://youtu.be/7XqfhLH2aDw

dxoverdy, 2023-05-21:
D7 which is output from the wemos, if disconnected, should result in zero
LED flashes.
I've uploaded a video here (Youtube insists it is a short not a proper
video :( ), https://www.youtube.com/shorts/q75st04LnK8, it shows D7
connected and no Alpha connected.  You can see just the RX led flashes each
time the wemos pings a message.  Nothing comes back because there is no
Alpha so the TX pin never flashes.  Disconnecting D7 mid-way through the
video demonstrates the RS485 stops getting pings from the wemos and so lies
dormant until I plug it back in.

What's the behaviour of yours if you unplug the alpha and record D7
connected for a while, D7 disconnected for a while and D7 reconnected?
Dan

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

dxoverdy, 2023-05-21:
Further, on closer look, you've unplugged D6, so the wemos is able to ping
messages via the wemos D7 tx pin (so 485 rx LED flashes) and it looks like
the 485 pings a message back via the 485 tx pin (tx led flashes) but the
wemos d6 RX pin is disconnected and so nothing happens.

[image: image.png]

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

dxoverdy, 2023-05-21:
ala
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

dxoverdy, 2023-05-21:
The email I got said unplugged D7, I think you've edited to D6.  Ok, so, as I say, nothing would flash differently in the case of D6 connected, it's just the wemos wouldn't get any message back to do anything.

D7 would be interesting, if you could do that demonstration as I wrote about above.

dxoverdy, 2023-05-21:
I've published a new version - v1.20.  Download the code, plumb in your WiFi and MQTT details and uncomment line 961 in Definitions.h (DEBUG_OUTPUT_TX_RX) and optionally 959, (DEBUG).

If you then use the serial monitor in the Arduino IDE, you will see the actual transmitted and received bytes.  This outputs the absolute raw data sent and received.  In the case of receive, I was curious as to whether your Wemos is receiving anything and if it is corrupted.  If you are getting some Rx bytes back and they aren't passing the CRC checks, that would also yield a BAD-CRC-UR, the same as nothing received at all.  If you could send me some of the Tx and Rx lines returned back we can then take next steps.

When plugged in.
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

When unplugged.
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

Spookster, 2023-05-21:
Will do, I'll let you know how I get on. I'll make it tomorrow's project. Thanks for the help

Spookster, 2023-05-21:
`D7 would be interesting, if you could do that demonstration as I wrote about above.`

Correct, it operates as you expect. Pulling D7 results in both leds not flashing - no signal from the D1 to the Max

Apologies for the D6/D7 edit further up, I thought I got it in time ;)
I initially wrote D7 and then realized I pulled D6.

Spookster, 2023-05-21:
This is with Alpha plugged in:
```
08:57:10.578 -> Timeout waiting for RS485 response.  Likely no more data coming.
08:57:10.648 -> Rx: Nothing
08:57:10.648 -> Tx: 55 03 08 86 00 01 6A 57
08:57:10.989 -> Timeout waiting for RS485 response.  Likely no more data coming.
08:57:11.059 -> Rx: Nothing
08:57:11.059 -> Tx: 55 03 08 87 00 02 7B 96
08:57:11.399 -> Timeout waiting for RS485 response.  Likely no more data coming.
08:57:11.466 -> Rx: Nothing
08:57:11.466 -> Tx: 55 03 04 1F 00 02 F9 29
08:57:11.499 -> Rx: 55 03 04 00 00 00 A1 2E 4E
08:57:11.531 -> Tx: 55 03 04 23 00 02 39 25
08:57:11.614 -> Rx: 55 03 04 00 00 00 80 EE 56
08:57:11.660 -> Tx: 55 03 04 27 00 02 78 E4
08:57:11.739 -> Rx: 55 03 04 00 00 00 00 EF F6
```
and without:

```
09:00:57.296 -> Timeout waiting for RS485 response.  Likely no more data coming.
09:00:57.365 -> Rx: Nothing
09:00:57.365 -> Tx: 55 03 08 87 00 02 7B 96
09:00:57.706 -> Timeout waiting for RS485 response.  Likely no more data coming.
09:00:57.775 -> Rx: Nothing
09:00:57.775 -> Tx: 55 03 04 1F 00 02 F9 29
09:00:58.114 -> Timeout waiting for RS485 response.  Likely no more data coming.
09:00:58.185 -> Rx: Nothing
09:00:58.185 -> Tx: 55 03 04 23 00 02 39 25
09:00:58.526 -> Timeout waiting for RS485 response.  Likely no more data coming.
09:00:58.595 -> Rx: Nothing
09:00:58.595 -> Tx: 55 03 04 27 00 02 78 E4
09:00:58.935 -> Timeout waiting for RS485 response.  Likely no more data coming.
09:00:59.005 -> Rx: Nothing
09:00:59.005 -> Tx: 55 03 04 2B 00 02 B8 E7
09:00:59.335 -> Timeout waiting for RS485 response.  Likely no more data coming.
09:00:59.412 -> Rx: Nothing
09:00:59.412 -> Tx: 55 03 04 2F 00 02 F9 26
09:00:59.756 -> Timeout waiting for RS485 response.  Likely no more data coming.
09:00:59.825 -> Rx: Nothing
09:00:59.825 -> Tx: 55 03 04 33 00 02 38 E0
09:01:00.166 -> Timeout waiting for RS485 response.  Likely no more data coming.
09:01:00.234 -> Rx: Nothing
09:01:00.234 -> Tx: 55 03 00 A1 00 02 98 3D
09:01:00.576 -> Timeout waiting for RS485 response.  Likely no more data coming.
09:01:00.643 -> Rx: Nothing
```

Spookster, 2023-05-21:
With a full debug, alpha disconnected:

```
09:09:31.762 -> Rx: Nothing
09:09:31.762 -> noResponse
09:09:31.840 -> Tx: 55 03 01 02 00 01 29 E2
09:09:32.241 -> Timeout waiting for RS485 response.  Likely no more data coming.
09:09:32.319 -> Timed Out (inByteNumZeroIndexed): 0
09:09:32.353 -> Timed Out (gotSlaveID): 0
09:09:32.386 -> Timed Out (gotFunctionCode): 0
09:09:32.420 -> Timed Out (resp->functionCode): 0
09:09:32.454 -> Timed Out (gotData): 0
09:09:32.454 -> Timed Out (resp->dataSize): 0
09:09:32.486 -> Rx: Nothing
09:09:32.519 -> Failed to addStateInfo for: 258, Result was: 4
09:09:32.553 -> Tx: 55 03 01 26 00 01 69 E9
09:09:32.868 -> Timeout waiting for RS485 response.  Likely no more data coming.
09:09:32.951 -> Timed Out (inByteNumZeroIndexed): 0
09:09:32.985 -> Timed Out (gotSlaveID): 0
09:09:33.019 -> Timed Out (gotFunctionCode): 0
09:09:33.052 -> Timed Out (resp->functionCode): 0
09:09:33.085 -> Timed Out (gotData): 0
09:09:33.085 -> Timed Out (resp->dataSize): 0
09:09:33.118 -> Rx: Nothing
```
And alpha connected:

```
09:12:44.369 -> Rx: 55 03 04 A8 5C 00 02 8E 45
09:12:44.400 -> Tx: 55 03 04 33 00 02 38 E0
09:12:44.477 -> Rx: 55 03 04 00 00 00 00 EF F6
09:12:44.523 -> Tx: 55 03 00 A1 00 02 98 3D
09:12:44.617 -> Rx: 55 03 04 00 00 00 00 EF F6
09:12:44.695 -> Tx: 55 03 04 1F 00 02 F9 29
09:12:44.744 -> Rx: 55 03 04 00 00 00 C9 2F A0
09:12:44.787 -> Tx: 55 03 04 23 00 02 39 25
09:12:44.833 -> Rx: 55 03 04 00 00 00 84 EF 95
09:12:44.910 -> Tx: 55 03 04 27 00 02 78 E4
09:12:45.020 -> Rx: 55 03 04 00 00 00 00 EF F6
09:12:45.066 -> Tx: 55 03 04 2B 00 02 B8 E7
09:12:45.113 -> Rx: 55 03 04 00 00 00 00 EF F6
09:12:45.159 -> Tx: 55 03 04 2F 00 02 F9 26
09:12:45.237 -> Rx: 55 03 04 A8 5C 00 02 8E 45
09:12:45.284 -> Tx: 55 03 04 33 00 02 38 E0
09:12:45.376 -> Rx: 55 03 04 00 00 00 00 EF F6
09:12:45.469 -> Tx: 55 03 10 00 00 01 8D 1E
09:12:45.862 -> Timeout waiting for RS485 response.  Likely no more data coming.
09:12:45.932 -> Timed Out (inByteNumZeroIndexed): 0
09:12:45.965 -> Timed Out (gotSlaveID): 0
09:12:45.999 -> Timed Out (gotFunctionCode): 0
09:12:46.032 -> Timed Out (resp->functionCode): 0
09:12:46.065 -> Timed Out (gotData): 0
09:12:46.065 -> Timed Out (resp->dataSize): 0
09:12:46.099 -> Rx: Nothing
```

Spookster, 2023-05-21:
Should I be concerned about the Ardrino output errors on building?
eg:

```
C:\Temp\Alpha2MQTT-master\Alpha2MQTT\RS485Handler.cpp: In member function 'void RS485Handler::outputFrameToSerial(bool, uint8_t*, byte)':
C:\Temp\Alpha2MQTT-master\Alpha2MQTT\RS485Handler.cpp:124:10: warning: 'char* strncat(char*, const char*, size_t)' specified bound 4 equals source length [-Wstringop-overflow=]
  124 |   strncat(_debugOutput, "Tx: ", 4);
      |   ~~~~~~~^~~~~~~~~~~~~~~~~~~~~~~~~
C:\Temp\Alpha2MQTT-master\Alpha2MQTT\RS485Handler.cpp:128:10: warning: 'char* strncat(char*, const char*, size_t)' specified bound 4 equals source length [-Wstringop-overflow=]
  128 |   strncat(_debugOutput, "Rx: ", 4);
      |   ~~~~~~~^~~~~~~~~~~~~~~~~~~~~~~~~
C:\Temp\Alpha2MQTT-master\Alpha2MQTT\RS485Handler.cpp:133:10: warning: 'char* strncat(char*, const char*, size_t)' specified bound 7 equals source length [-Wstringop-overflow=]
  133 |   strncat(_debugOutput, "Nothing", 7);
      |   ~~~~~~~^~~~~~~~~~~~~~~~~~~~~~~~~~~~
C:\Temp\Alpha2MQTT-master\Alpha2MQTT\RS485Handler.cpp:143:12: warning: 'char* strncat(char*, const char*, size_t)' specified bound 1 equals source length [-Wstringop-overflow=]
  143 |     strncat(_debugOutput, " ", 1);
      |     ~~~~~~~^~~~~~~~~~~~~~~~~~~~~~
In file included from C:\Temp\Alpha2MQTT-master\Alpha2MQTT\RegisterHandler.h:33,
                 from C:\Temp\Alpha2MQTT-master\Alpha2MQTT\Alpha2MQTT.ino:15:
C:\Temp\Alpha2MQTT-master\Alpha2MQTT\Alpha2MQTT.ino: In function 'void sendData()':
C:\Temp\Alpha2MQTT-master\Alpha2MQTT\Definitions.h:46:21: warning: ISO C++ forbids converting a string constant to 'char*' [-Wwrite-strings]
   46 | #define DEVICE_NAME "Alpha2MQTT"
      |                     ^
C:\Temp\Alpha2MQTT-master\Alpha2MQTT\Alpha2MQTT.ino:1058:82: note: in expansion of macro 'DEVICE_NAME'
 1058 |   sendDataFromAppropriateArray(_mqttTenSecondStatusRegisters, numberOfRegisters, DEVICE_NAME MQTT_MES_STATE_SECOND_TEN);
      |                                                                                  ^~~~~~~~~~~
C:\Temp\Alpha2MQTT-master\Alpha2MQTT\Definitions.h:46:21: warning: ISO C++ forbids converting a string constant to 'char*' [-Wwrite-strings]
   46 | #define DEVICE_NAME "Alpha2MQTT"
      |                     ^
C:\Temp\Alpha2MQTT-master\Alpha2MQTT\Alpha2MQTT.ino:1065:82: note: in expansion of macro 'DEVICE_NAME'
 1065 |   sendDataFromAppropriateArray(_mqttOneMinuteStatusRegisters, numberOfRegisters, DEVICE_NAME MQTT_MES_STATE_MINUTE_ONE);
      |                                                                                  ^~~~~~~~~~~
C:\Temp\Alpha2MQTT-master\Alpha2MQTT\Definitions.h:46:21: warning: ISO C++ forbids converting a string constant to 'char*' [-Wwrite-strings]
   46 | #define DEVICE_NAME "Alpha2MQTT"
      |                     ^
C:\Temp\Alpha2MQTT-master\Alpha2MQTT\Alpha2MQTT.ino:1072:83: note: in expansion of macro 'DEVICE_NAME'
 1072 |   sendDataFromAppropriateArray(_mqttFiveMinuteStatusRegisters, numberOfRegisters, DEVICE_NAME MQTT_MES_STATE_MINUTE_FIVE);
      |                                                                                   ^~~~~~~~~~~
C:\Temp\Alpha2MQTT-master\Alpha2MQTT\Definitions.h:46:21: warning: ISO C++ forbids converting a string constant to 'char*' [-Wwrite-strings]
   46 | #define DEVICE_NAME "Alpha2MQTT"
      |                     ^
C:\Temp\Alpha2MQTT-master\Alpha2MQTT\Alpha2MQTT.ino:1079:80: note: in expansion of macro 'DEVICE_NAME'
 1079 |   sendDataFromAppropriateArray(_mqttOneHourStatusRegisters, numberOfRegisters, DEVICE_NAME MQTT_MES_STATE_HOUR_ONE);
      |                                                                                ^~~~~~~~~~~
C:\Temp\Alpha2MQTT-master\Alpha2MQTT\Definitions.h:46:21: warning: ISO C++ forbids converting a string constant to 'char*' [-Wwrite-strings]
   46 | #define DEVICE_NAME "Alpha2MQTT"
      |                     ^
C:\Temp\Alpha2MQTT-master\Alpha2MQTT\Alpha2MQTT.ino:1086:79: note: in expansion of macro 'DEVICE_NAME'
 1086 |   sendDataFromAppropriateArray(_mqttOneDayStatusRegisters, numberOfRegisters, DEVICE_NAME MQTT_MES_STATE_DAY_ONE);
      |                                                                               ^~~~~~~~~~~
C:\Temp\Alpha2MQTT-master\Alpha2MQTT\Alpha2MQTT.ino: In function 'void sendDataFromAppropriateArray(mqttState*, int, char*)':
C:\Temp\Alpha2MQTT-master\Alpha2MQTT\Alpha2MQTT.ino:1103:38: warning: ISO C++ forbids converting a string constant to 'char*' [-Wwrite-strings]
 1103 |  resultAddedToPayload = addToPayload("{\r\n");
      |                                      ^~~~~~~
C:\Temp\Alpha2MQTT-master\Alpha2MQTT\Alpha2MQTT.ino:1122:40: warning: ISO C++ forbids converting a string constant to 'char*' [-Wwrite-strings]
 1122 |    resultAddedToPayload = addToPayload("}");
      |                                        ^~~
C:\Temp\Alpha2MQTT-master\Alpha2MQTT\Alpha2MQTT.ino: In function 'void mqttCallback(char*, byte*, unsigned int)':
C:\Temp\Alpha2MQTT-master\Alpha2MQTT\Alpha2MQTT.ino:1590:39: warning: ISO C++ forbids converting a string constant to 'char*' [-Wwrite-strings]
 1590 |     resultAddToPayload = addToPayload("{\r\n");
      |                                       ^~~~~~~
C:\Temp\Alpha2MQTT-master\Alpha2MQTT\Alpha2MQTT.ino:1608:41: warning: ISO C++ forbids converting a string constant to 'char*' [-Wwrite-strings]
 1608 |       resultAddToPayload = addToPayload("}");
      |                                         ^~~
C:\Temp\Alpha2MQTT-master\Alpha2MQTT\Alpha2MQTT.ino:1762:37: warning: ISO C++ forbids converting a string constant to 'char*' [-Wwrite-strings]
 1762 |   resultAddToPayload = addToPayload("{\r\n");
      |                                     ^~~~~~~
```

Spookster, 2023-05-21:
And running slave address finder :

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

Spookster, 2023-05-21:
Wait!  success!
I was looking through the alpha web management and came across an upgrade that hadnt been applied.
I didnt screen shot it as I didnt think it would be relevant, but something like BMS 1.02 to 1.03

After applying that, its working! So it seems the BMS update cured the problem

Spookster, 2023-05-22:
There are a few weird and inconsistent values coming through, but I guess Ill give it a few days to settle and get some history.

Do the values vary from model to model?

dxoverdy, 2023-05-22:
That’s great news!
I noticed in one of your earlier messages you were getting responses back
to certain messages, but not others:

09:12:45.376 -> Rx: 55 03 04 00 00 00 00 EF F6
09:12:45.469 -> Tx: 55 03 10 00 00 01 8D 1E
09:12:45.862 -> Timeout waiting for RS485 response.  Likely no more data coming.

As for inconsistent values, tell me what you’re seeing for one
register in particular and we can take it from there.

Congrats again!

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

Spookster, 2023-05-22:
Thats caused by data spike like so:
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

dxoverdy, 2023-05-22:
Its not beyond the realms of possibility the calculations I have which create REG_CUSTOM_LOAD are wrong....

When you are seeing load reporting ridiculous figures again, can you send me a raw ten send state payload from MQTT Explorer?

LOAD is calculated by using the following values from that ten second state

REG_PV_METER_R_TOTAL_ACTIVE_POWER_1
REG_INVERTER_HOME_R_PV1_POWER_1
REG_INVERTER_HOME_R_PV2_POWER_1
REG_INVERTER_HOME_R_PV3_POWER_1
REG_INVERTER_HOME_R_PV4_POWER_1
REG_INVERTER_HOME_R_PV5_POWER_1
REG_INVERTER_HOME_R_PV6_POWER_1 REG_GRID_METER_R_TOTAL_ACTIVE_POWER_1
REG_BATTERY_HOME_R_BATTERY_POWER

My hope is that one of those of those is high which will give me a focal point, because at the moment the calculations *look* right...

Thanks

Spookster, 2023-05-22:
I havent had a chance to have a close look at your calcs yet, but will
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

And from a different NR component:
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

Spookster, 2023-05-22:
When you say to get the values from MQTT explorer, can you go back and fetch that historical data?
These were the figures over night:
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

Spookster, 2023-05-22:
Here we go:
Before spike
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

Actual spike:
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

After Spike:
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

The only thing I note, which is odd, is the REG_INVERTER_HOME_R_INVERTER_TEMP disappears during the spike?

Spookster, 2023-05-23:
(Sorry for all the posts!)
I did some more monitoring, and of interest I enabled CONSUMPTION in node red (just debug output) and it appeared to be unaffected by the spike:

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

Spookster, 2023-05-23:
After monitoring CONSUMPTION, it also spiked :

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

dxoverdy, 2023-05-23:
Good investigatory work - indeed CONSUMPTION was done at the javascript/node red level as opposed to on the chip.  I'm shocked that is affected, I've just spent the last ten minutes thinking it was likely an overflow or underflow, but I think that's kyboshed that thought.

I'm interested in the raw bytes for REG_CUSTOM_LOAD.  Can you ping the following message to it when it is reporting a spike?

Topic: Alpha2MQTT/request/read/register/handled
Payload:
{
    "registerAddress": "0xFFFE"
}

You'll get a response on Alpha2MQTT/response/read/register/handled
Thanks

Spookster, 2023-05-23:
Data affected:
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

Spookster, 2023-05-23:
> I'm interested in the raw bytes for REG_CUSTOM_LOAD. Can you ping the following message to it when it is reporting a spike?
Am I able to ping a specific time?
Im not sure how I get that data for the 10 second window it happens

dxoverdy, 2023-05-23:
At any point in Home Assistant's history for .... haha you've just posted it a pic.

Is it just Grid Power which goes off the rails?  The three power figures which contribute to 'load' are PV power, grid power and battery power.

Spookster, 2023-05-23:
Yes, just Grid
This is the filter without the GRID and calculated values :

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

dxoverdy, 2023-05-23:
Awesome, thanks.  Could you post the same graph with just grid power for the same period?

Spookster, 2023-05-23:
Just GRID:
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

dxoverdy, 2023-05-23:
Could you narrow the graph to just show this period?
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

Spookster, 2023-05-23:
Just exporting power :
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

dxoverdy, 2023-05-23:
Humour me will you and give me a bit of an idea of your system.
Are you single or three phase, do you have a grid meter inside your consumer unit which tells the Alpha what grid usage you have, or is it a CT clamp?

Spookster, 2023-05-23:
Single phase, CT clamp inside switch board

Spookster, 2023-05-23:
Or would you call that a grid meter? The solar CT is the black one
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

dxoverdy, 2023-05-23:
That makes sense.  The CT is wrapped around your PV to tell the Alpha what you're making, and the grid meter
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

Thread 11 (2023-05-25):

Feature Request: ESPHome support

dan-s-github, 2023-05-25:
I wonder if it would be possible to use ESPHome to build and install this package on the Controller.

Would make installation of the software much easier for some users

dan-s-github, 2023-05-28:
Just stumbled over this project here which has an interesting custom pcb for interaction with CAN
https://github.com/vekexasia/comfoair-esp32

dxoverdy, 2023-10-01:
That would be a separate project with different hardware.  If memory serves there are modbus integrations right out the box in esp home but you’d need to code and appreciate handle/calculate each register individually.

dan-s-github, 2023-10-02:
I ordered a https://docs.m5stack.com/en/atom/atomic485 and will do some testing on this as soon as I get access to the modbus interface. Unfortunately I currently have a replacement Smile5 v1 where I can't get access to the ports from the front.
Initial request though was to be able to build and deploy the current code using ESPHome, but that might still be tricky and not all components you use would be supported.
I am also playing with an https://shop.m5stack.com/products/atoms3-dev-kit-w-0-85-inch-screen as part of my prep

Closed 2023-10-01.

Thread 13 (2023-06-01):

RS485 types

Spookster, 2023-06-01:
Would a smaller 3485 module such as this work?
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

Im thinking purely from a smaller form factor

dxoverdy, 2023-06-01:
I see no reason why not, go for it.

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

dc42, 2023-07-08:
You will need to connect the EN pin of the board to pin D5 of the ESP. Other than that, I think it should work.

The reason is that the board you pictured really does use a MAX3485 chip, whereas the larger red PCBs pictured in this project don't! They use a a MAX13487E chip. That chip has an auto transmit/receive mechanism built into it, whereas the MAX3485 doesn't. Incidentally, the MAX13487 chip is intended for 5V operation, not 3.3V; so ideally anyone using the red board should power it from 5V and use a potential divider between the TXD pin on the red board (which is the receiver output, so should really be called RXD IMO) and the ESP8266 pin to reduce the signal level to 3.3V.

Spookster, 2023-07-08:
Good information thanks!
Yes, EN to D5 does indeed work

Spookster, 2023-07-09:
What I ended up with for now. I had to make do with the only rj45 that was available

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

Closed 2023-07-11.

Thread 14 (2023-07-08):

How to enable Modbus on 2022 SMILE5

dc42, 2023-07-08:
Hi, I've built one of these (thanks for the project!) but I'm having problems with Modbus communication. My SMILE5 has 4.8V between pins 4 and 5 as expected when the Alpha2MQTT isn't connected. Using a scope I can see that Alpha2MQTT is transmitting at 9600b on those pins, but there is no response received from the SMILE5. So I suspect that Modbus is disabled. However, I can't find anywhere to enable it in the Settings menu of the Smile5. After selecting Settings and entering the password, I get only two options: System and Restart (there is no Function entry). System just lets me select Date/Time, Ethernet, New Password, and Exit. Can anyone tell me how to enable Modbus? The SMILE5 component versions reported are:

Inverter V02.05
Charger V01.18
EMS V1.02.50
BMS V11.91

Thanks!

Spookster, 2023-07-08:
How do you get the reported versions, and Ill compare with mine

Experiences vary with accessing MODBUS it seems
https://www.facebook.com/groups/629803784169356/search/?q=modbus

Spookster, 2023-07-08:
Inverter  V1.48
Charger V1.48
EMS V1.02.68
BMS V1.04

Im in NZ, so may explain the different firmware.
Youve checked the system for updates? Mine didnt flag as being available until I checked

dxoverdy, 2023-07-09:
A lot of Smile 5s are struggling.  A chap I’ve come to know in the UK had his Smile 5 unit swapped out because of it and it worked first time.  If I recall he said the hardware was different.

I also read the Smile 5 is a bit more picky when it comes to RS485 timings.

Can I ask, given your knowledge on the MAX3485 on the other thread, what you actually built?

I am wondering if a MAX3485 chip with the flow control pin and a 3.3V/5V logic shifter could be more suitable?

dc42, 2023-07-09:
Thanks to all of you who responded so quickly. I should have mentioned that I am in the UK.

What I put together is a ESP32 Devkit V1, a board sold as a MAX3485 board (but that actually uses a MAX13847E) that looks identical to the one in the pictures in the README file, and a OLED display purchased in a pack of 5 from Amazon. I amended the code to use hardware serial on the ESP32 instead of software serial. I also fixed a bunch of compiler warnings, most of which were benign but a few of which could lead to buffer overflows, for example if unexpected data was received over Modbus (I have a policy of never trusting data from an external source). The code is in my fork of Alpha2MQTT at https://github.com/dc42/Alpha2MQTT/tree/master; however I don't advise anyone to use it until I have RS485 reception working, in case the switch to hardware serial needs some additional changes. I power the setup from the USB port of a 13A socket connected to the UPS output of the SMILE5.

Currently the display works and the ESP connects to WiFi and MQTT, but doesn't connect to the SMILE5. I used an oscilloscope to look at the Modbus signals, to confirm that the adapter board was transmitting at 9600b (after I corrected a TXD/RXD wire swap) and that the SMILE5 wasn't returning any data. I have another interface board on order in case my swapping TXD/RXD originally broke something.

However, having read the comments on Facebook I am wondering whether AlphaESS has deliberately disabled the Modbus setting, perhaps to prevent users from commanding discharge to the grid. I hadn't previously notice that "self consumption only" was part of the warranty condition. Perhaps that bit was added after my inverter was installed; I will locate my user manual and check.

As to the best choice of RS485 interface board, there are a few considerations:

- Is it best to work with 5V signal levels on the Modbus, or are 3.3V signals sufficient? In theory, 3.3V should be sufficient.
- Is additional protection on the RS485 A and B inputs needed? The red boards sold as MAX3485 boards have this extra protection network.
- Is it acceptable to run a chip specified for 5V operation from 3.3V? As a professional engineer my answer is no. But running chips out-of-specification is quite common in hobby projects.

Solutions to the Modbus interface that don't run the interface chip out of spec include:
1. Red board powered from 5V, with 2 resistors (potential divider) to reduce the signal level to the receive input of the ESP from 5V to 3.3V. Level shifting the other way isn't needed because the MAX13847E only needs 2.0V signal input.
2. As above but MAX485 board (again, only the data output needs level shifting down to 3.3V).
3. (simplest) True MAX3485 board (see https://github.com/dxoverdy/Alpha2MQTT/issues/13) powered from 3.3V.

Spookster, 2023-07-10:
When I was trying to sort mine out, Daniel suggested Arduino . tools > serial monitor to see what was going on. I assume you have, or does that give any debug clues?

dxoverdy, 2023-07-10:
I’ve bought an esp32, a couple of max485-ttl modules (the blue 5v ones), a couple of the genuine max3485 boards (genuine 3.3v with the EN pin) and some 3.3v-5v logic shifters.

I’ll get the code compiling and working with my existing red TTL board with the curious MAX13847E, then I’ll try all the other combinations and post findings.

I think that is probably the only sensible starting point.

Alpha have explicitly said they don’t disable modbus, someone I know went to one of their shows and asked the techies and they reported yes they removed the option but it was simply to make it “always on”.  All their other systems have it on by default, I suppose it made no sense to retain a pointless option on one system.

As I said, I also read somewhere that a specific revision of Smile 5 hardware is notoriously finicky about rs485 timings and I think it is prudent to take the auto-switching of TX/RX out of the equation too.

My gut feeling historically has been when they removed the modbus enable option, some systems if disabled are possibly remaining disabled but getting their tech to acknowledge is difficult.  I tend to message the German team as they are on it but then I struggle behind Google Translate.

UK too by the way :)

dc42, 2023-07-10:
@Daniel, I published the code I used for the ESP32 at
https://github.com/dc42/Alpha2MQTT/tree/master/Alpha2MQTT. The changes I
made are summarised at
https://github.com/dc42/Alpha2MQTT/tree/master/Alpha2MQTT. It's possible
that with the change to use a hardware serial port, it may be necessary to
flush the receive buffer immediately after transmitting, I'll check that
if/when I start getting responses from the SMILE5.

I've also ordered a genuine MAX3485 board, and I have a MAX485 chip
already; so I can try using those to take the auto switching out of the
equation as you suggested.

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

--
David Crocker, Duet3D Ltd.

dc42, 2023-07-17:
I tried connecting a MAX485 board powered from 5V, with its RO output
connected to the ESP32 RX2 input via a couple of resistors to reduce the
voltage to 3.3V. I found I had to modify the Alpha2MQTT code to keep the
transmit control pin high until the transmission has finished, due to my
use of a hardware serial port. But even with that fixed, the result was the
same as before: I can see the data transmitted by Alpha2MQTT on the Modbus,
but there is no response from the inverter. I modified the code to request
the serial number registers on each loop iteration until it read them
successfully, then used an oscilloscope to read the data being sent. It
reads 55 03 07 43 00 08 B9 78 which looks correct to me including the CRC.
I tried holding the data output high for a couple of milliseconds before
starting transmission, but that didn't help. Neither did adding a ground
wire between the Alpha2MQTT and the inverter casing (Modbus components are
supposed to have a common ground), and neither did using a different 5V USB
power supply.

So I think either Modbus is still disabled on my SMILE5 despite the absence
of a means to enable it in the Setup menu, or there is something wrong with
the Modbus interface on my SMILE5.

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

--
David Crocker, Duet3D Ltd.

dxoverdy, 2023-07-17:
Comprehensive.  I’m still waiting for my bits to arrive but I’ll will amend
the code for each of the scenarios and ensure it works with mine, you can
then try that code and hardware setup.

Do you have voltage on pins 3 and 6?

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

dc42, 2023-07-17:
I have no voltage between pins 3 and 6, just 4.88V between 4 and 5 with no load. There is no voltage between 2 and 7 but there is 120 ohm resistance between those pins, so I think those are the CAN pins.

The Modbus manual appears to confirm that pins 4 and 5 are correct:
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

dc42, 2023-07-17:
@Spookster I already tried upgrading the firmware through the app, in Function -> Upgrade management. It says I am running the latest version.

dxoverdy, 2023-07-21:
I've added ESP32 support (in a limited guise) - All the instructions to swap are in the 1.21.txt release notes.  Essentially change a couple of definitions and follow the alternate pinout.  It won't be a problem for you.  It also supports the screen.  It uses HardwareSerial using Serial2 and one of the many spare digital IO pins for directional control.

So.  Something which will give you hope.  Certain combinations I can't get working with my tried and tested Smile B3... I ran out of time today to flirt with timings and pins etc.... ButI suspect it is to do with control pins or timings anyway.  I can literally swap the board to the red module while turned on and it will come to life.  All combinations work on the ESP8266 which is curious too.

ESP8266 with the Red Module - Working
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

ESP8266 with the Small Factor MAX3485 Working:
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

ESP8266 with the Blue Module (MAX485) with Voltage Shifter Working:
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

ESP8266 with Red Module Voltage Shifter Working
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

ESP32 with Red Module Working (First attempt)
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

ESP32 with Red Module (Rearranged as the jumper wires were getting awful) - Working
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

ESP32 with Blue Module Voltage Shifter (Rearranged) - Not Working
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

ESP32 with Blue Mini Chip with Voltage Shifter - Not working
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

Give the code a go with your setup and see if it works.

dc42, 2023-07-23:
Thanks for adding the ESP32 support. It's interesting that with the wide blue module you get a CRC error; whereas I don't get any response from the inverter at all. That does suggest a timing error.

I'll try my setup with your code. I'll also try removing the 120 ohm termination resistor from the wide blue module.

dc42, 2023-07-23:
@dxoverdy I think your ESP32 code is missing the change needed to delay switching the transceiver over to receive until the whole packet has been transmitted. See this part of my code https://github.com/dc42/Alpha2MQTT/blob/cd50622da9c32cc09d3f9fe7ceb25e3c57303960/Alpha2MQTT/RS485Handler.cpp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. If you add this, and perhaps remove the delay(100) call that you added at line 111 of your code, I think it may solve your CRC issue.

I observed on the oscilloscope that without this change, transmission was curtailed. It's because when you write a block to HardwareSerial, the data goes into a buffer and is sent by an interrupt service routine, so the write call returns before all the data has been sent.

dxoverdy, 2023-07-23:
I must clarify, the error message is kinda generic.  There is no
differentiation on the display between CRC and no response.  I’ll modify
the code tomorrow to be a bit more informative in that regard.

I got zero response from the modules dependent on a flow control pin on the
ESP32, but the red module auto sensing flow control worked fine on the
ESP32.

All combinations worked on the ESP8266 so in conclusion I’m very
comfortable that the hardware TX/RX of UART2 (ESP32) is fundamentally sound
because it worked with the red module.

Given that flow control works fine on pin D5 of the ESP8266 I can only come
to the conclusion that either the single pin I’ve tried on the ESP32 so far
is not suitable despite the fact I do get 3.3v when I forced it high for 5
seconds, or the ESP32 isn’t clearing the flow control quick enough.  When
im back home tomorrow I’ll play with timings.

If I don’t get anywhere then specifically on a wide blue module I’d like to
try tying DE to 3.3 so transmission always active and only forcing RE low
for receipt in code…. And perhaps a better idea, tying RE to ground and
only forcing DE high for the period of transmission.

Dan

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

dxoverdy, 2023-07-23:
I will give that a go buddy late tonight when I’m back or tomorrow and
report back.

I am new to the hardwareserial/ESP32 and working blind without an
oscilloscope:)

Thanks
Dan

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

dc42, 2023-07-23:
>> I got zero response from the modules dependent on a flow control pin on the
ESP32, but the red module auto sensing flow control worked fine on the
ESP32.

All combinations worked on the ESP8266 so in conclusion I’m very
comfortable that the hardware TX/RX of UART2 (ESP32) is fundamentally sound
because it worked with the red module.
<<

That confirms that the issue is with the timing of switching the transmit/receive command pin. The red module doesn't use that signal. On the ESP8266 you use SoftwareSerial, so the write() call doesn't return until all the data has been sent.

I've found a NodeMCU ESP8266 module in my spares box, so I'll try using that with your code.

dc42, 2023-07-23:
I've got the inverter to respond to Modbus commands at last. This is what I did:

- I tried using your code (latest version on Github) on my version 0.9 ESP8266 NodeMCU. To get it to compile I had to change SERIAL_8N1 on line 33 of RS485Handler.cpp to SWSERIAL_8N1. Unfortunately the OLED display doesn't work - it prints some random-looking dots and then clears the lower ~25% of the display. [Perhaps the latest OLED library isn't compatible with ESP8266]. On the bench, serial monitor showed that it connected to WiFi and MQTT successfully and gave the expected Modbus timeout messages. When connected to the inverter (no serial monitor available), the oscilloscope showed no responses from the inverter.
- I removed the 120 ohm termination resistor from the blue board. No change.
- I try my fork of Alpha2MQTT on the ESP8266 NodeMCU. Same thing (display not working, no Modbus connection).
- I investigated the signals on Modbus. I found that with the Alpha2MQTT disconnected, there is a common mode voltage at 50Hz  with amplitude more than 80V peak to peak (31V RMS according to my meter). But the current sourced is only 100uA RMS, so the common mode voltage all but disappears when the Alpha2MQTT is connected and grounded via the oscilloscope.
- Further testing with a multimeter indicated that pin 3 of the RJ45 connector is almost certainly the RS485 COM connection. So I have connected it to ground of the Alpha2MQTT.
- I reverted to the ESP32 version because that has a working display, and re-tested. Still no communication.
- Thinking that the baud rate could be wrong, I changed the code to change the baud rate each time it failed to get the serial number, scanning over a range of baud rates that I found in the Alpha-ESS literature. Now I get a connection!
- The odd thing is, when it connects the baud rate is 9600, the same as I originally set! When I power up the Alpha2MQTT it initially gives the "not known" message indicating that fetching the serial number at the initial baud rate (still 9600) fails; but within a few seconds it connects. So I think trying to connect at the wrong baud rate must be priming the inverter in some way.
I'll do some experiments to see which of the incorrect baud rates need to be tried before a successful connection is possible.

dxoverdy, 2023-07-23:
Great finds so far!

I’ve just checked the 8N1 and I stupidly haven’t put that begin within the
ESP32 section and a second .begin for software serial.

Too eager to get something to you before I went away for the weekend.

I will move that line and implement later today.

It should be

#if defined MP_ESP8266
_RS485Serial = new SoftwareSerial(RX_PIN, TX_PIN);

_RS485Serial->begin(INVERTER_BAUD_RATE);

#elif defined MP_ESP32
_RS485Serial = new HardwareSerial(2); // Serial 2 PIN16=RXgreen,
pin17=TXwhite

_RS485Serial->begin(INVERTER_BAUD_RATE, SERIAL_8N1);

#endif

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

Thread 15 (2023-07-11):

Integrating into Battery Controller

flatmax, 2023-07-11:
Lovely piece of work - great detail and information. Amazing that you got the charge/discharge working.

I wrote a battery controller and I would love to integrate your work into it. Here is a link :
https://github.com/flatmax/BatteryController

I have a setup where I am already probing the fuse box for production/consumption using an Enphase Envoy. I also now have two ACR100R meters, one for consumption and one for production. So I have a few ways to get production/consumption data.

If I want to control the alpha ESS batteries, then I guess I can construct your hardware. But is there any reason why we can't use your software directly through a USB to RS845 adapter ? If so then will your code compile down on linux ?

inmanelectric, 2023-12-11:
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
I would like to know if
If it would be possible to get the Alpha ESS M48112-s batteries to communicate with a Deye 29.9 kilowatt three phase inverter via a RS 485 / modbus device
Is there a way ?

Closed 2024-04-29.

Thread 16 (2023-07-25):

Feature Request: modbus/tcp support

aw1604, 2023-07-25:
Hello,
Would it be possible to add direct modbus/tcp support ? For example, the Smile-T10 with current software update supports modbus on port 502/tcp (and I can pull data using home-assistant modbus/tcp directly). So basically I'm just missing the AlphaESS-Frontend, while the data is already in HA without any ESP/serial-to-network controller.

Best Regards,
Andreas

PS: I am not a coder, but willing to sponsor some work on this

dxoverdy, 2023-07-25:
I converted 80% into Python as I would rather use modbus over tcp but at
the last minute Alpha told me the Smile B3 doesn’t support it so I can’t
develop it further, unless someone with a working tcp ip device could give
me access to their home assistant and network details of their alpha system
so I can finish it.

There is also less interest to fight too seeing as I can’t benefit from
what I do ha!

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

dc42, 2023-07-26:
@aw1604 I didn't realise that Alpha ESS had implemented Modbus TCP yet, the last I heard was that it was planned. What settings in configuration.yaml are you using to access your inverter? I just tried the following but it isn't working:

```
modbus:
  - name: SMILE5
    type: tcp
    host: 192.168.1.70
    port: 502
    sensors:
      - name: "Grid power"
        slave: 0x55
        address: 0x0021
        input_type: holding
        unit_of_measurement: W
        state_class: measurement
        count: 2
        data_type: int32
        scan_interval: 10
        unique_id: "modbustcp_grid_power"
```

dxoverdy, 2023-07-26:
Very few devices support it and I get the feeling from speaking to Alpha it
is not something they have an interest in adding to existing devices.

Hope that changes of course, it would be cool!

PS needs to be on Ethernet, WiFi full stop doesn’t expose it on supported
devices.

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

dc42, 2023-07-26:
@dxoverdy thanks. My inverter is connected via WiFi, also it's SMILE 5 not a T10. So I'll stick with Alpha2MQTT.

RolfDeL, 2023-07-26:
Hi Dan,
If you want you can use my system. As you know the Alpha2mqtt integration is already implemented and working on my HA. Maybe this way you could double-check with the original code your TCP work.
Next week I will (hopefully) get a new internet router, so my network could change.

Also, in the near future I will get a EV charger from AlphaESS, and for now it uses the modbus.

KR
Rolf

dxoverdy, 2024-01-05:
I'd be interested in pursuing this Rolf if you are.  Can I presume you integrated your Alpha2MQTT with something like Home Assistant?

The best way would be a Home Assistant instance opened up to the outside world so I can access.  We will install the Python integration and I'll see where I get to with the script I concocted.

Feel free to check back in on email if you fancy it.  Thanks :)

Thread 17 (2023-09-27):

Data freezing

Spookster, 2023-09-27:
I dont believe this is a software issue, but has anyone experienced a freezing of data output recently?
As below, the unit stops sending data.
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

Its happened multiple times over the last week, after running reliably for months.
I thought it may have been hardware, however swapping to a complete new unit has the same issue.
Network cable to unit replaced, same issue.

It makes me wonder if theres perhaps been a software update or fault at the ESS end.

Next step is to try and run #debug to see if anything shows up there

DannyBoy-PI, 2023-09-27:
Hi Dan,

No, I haven't seen that issue. Only issue I currently have is the registers for minutes (charging) don't seem to be right (for Smile B3 anyway). I have logged a ticket with Alpha to see if they can throw any light on it.

Regards,

Dan.

Sent from Outlook for Android<https://aka.ms/AAb9ysg>

________________________________
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

Spookster, 2023-10-02:
So far, resetting the main ESS unit appears to have fixed the problem

rodgers86, 2024-04-14:
Hi have you had any further issues like this?

In the last week this has happened 3 times.

Rebooting Node-Red in Proxmox seems to instantly fix it. But I’ve still not worked out why it’s happening's.

Closed 2023-10-03.

Thread 18 (2023-10-04):

Inconsistent retrieval and lots of timeouts

ffrog8, 2023-10-04:
I've spent a long while getting Alpha2MQTT to talk to my smile 5. After re-reading  #14  addressing some broken cable I finally got messages appearing in MQTT :). Unfortunately when reviewing the 10sec MQTT history it looks like a random set of the registers are being returned, sometimes none at all. Any suggestions, ideas welcomed.

```
10/02/2023 12:20:59 PM(-13.9 seconds)

{
}

10/02/2023 12:20:43 PM(-16.54 seconds)

{
    "REG_BATTERY_HOME_R_VOLTAGE": 50.30,
    "REG_INVERTER_HOME_R_CURRENT_L1": 3.10,
    "REG_INVERTER_HOME_R_PV5_POWER_1": 0,
}

10/02/2023 12:20:29 PM(-13.62 seconds)

{
    "REG_INVERTER_HOME_R_PV2_POWER_1": 2234,
    "REG_INVERTER_HOME_R_PV3_POWER_1": 0,
    "REG_INVERTER_HOME_R_PV5_POWER_1": 0,
    "REG_INVERTER_HOME_R_PV6_POWER_1": 0,
}

10/02/2023 12:20:15 PM(-14.7 seconds)

{
    "REG_BATTERY_HOME_R_VOLTAGE": 50.30,
    "REG_GRID_METER_R_TOTAL_ACTIVE_POWER_1": 0,
    "REG_INVERTER_HOME_R_PV5_POWER_1": 0,
    "REG_INVERTER_HOME_R_PV6_POWER_1": 0,
}

```

Here is what I see on the serial port. The Alpha Serial Number is correct but i'm not sure what to try to fix the timeouts?

```Connecting to XXXXXXX
WiFi connected, IP isXXXXXXAbout to request buffer
Requesting a buffer of : 4608 bytes
_bufferSize: 4608,

_maxPayload (Including null terminator): 4096
About To Try: 115200
Alpha Serial Number: ALXXXXXXX
Attempting MQTT connection...Connected MQTT
Timeout waiting for RS485 response.  Likely no more data coming.
Timed Out (inByteNumZeroIndexed): 0
Timed Out (gotSlaveID): 0
Timed Out (gotFunctionCode): 0
Timed Out (resp->functionCode): 0
Timed Out (gotData): 0
Timed Out (resp->dataSize): 0
noResponse
Timeout waiting for RS485 response.  Likely no more data coming.
Timed Out (inByteNumZeroIndexed): 0
Timed Out (gotSlaveID): 0
Timed Out (gotFunctionCode): 0
Timed Out (resp->functionCode): 0
Timed Out (gotData): 0
Timed Out (resp->dataSize): 0
Failed to addStateInfo for: 258, Result was: 4
Timeout waiting for RS485 response.  Likely no more data coming.
Timed Out (inByteNumZeroIndexed): 0
Timed Out (gotSlaveID): 0
Timed Out (gotFunctionCode): 0
Timed Out (resp->functionCode): 0
Timed Out (gotData): 0
Timed Out (resp->dataSize): 0
Failed to addStateInfo for: 65533, Result was: 4
Timeout waiting for RS485 response.  Likely no more data coming.
Timed Out (inByteNumZeroIndexed): 0
Timed Out (gotSlaveID): 0
Timed Out (gotFunctionCode): 0
Timed Out (resp->functionCode): 0
Timed Out (gotData): 0
Timed Out (resp->dataSize): 0
Failed to addStateInfo for: 2182, Result was: 4
Timeout waiting for RS485 response.  Likely no more data coming.
Timed Out (inByteNumZeroIndexed): 0
Timed Out (gotSlaveID): 0
Timed Out (gotFunctionCode): 0
Timed Out (resp->functionCode): 0
Timed Out (gotData): 0
Timed Out (resp->dataSize): 0
Failed to addStateInfo for: 2183, Result was: 4
Failed to addStateInfo for: 1059, Result was: 2
Timeout waiting for RS485 response.  Likely no more data coming.
Timed Out (inByteNumZeroIndexed): 0
Timed Out (gotSlaveID): 0
Timed Out (gotFunctionCode): 0
Timed Out (resp->functionCode): 0
Timed Out (gotData): 0
Timed Out (resp->dataSize): 0
Failed to addStateInfo for: 1063, Result was: 4
Timeout waiting for RS485 response.  Likely no more data coming.
```

dxoverdy, 2023-10-04:
I asked if you were rocking 115200 on email, maybe you missed it!  It seems
you very much are.

Try this, this worked for another fella:

“Lastly, it could be that the inverter is struggling to process lots of
messages in sequence.  Therefore, you could put a delay between each send
by adding a delay(80); to line 105 of RS485Handler.cpp (currently blank)
which will enforce a rough 1/12th second delay before requests are sent.”

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

ffrog8, 2023-10-04:
Okay I'll flagpole that and report back. Cheers!

ffrog8, 2023-10-04:
Mostly the same results unfortunately.

For some reason on the third reboot (output below) no Alpha serial was output?

```

Timed Out (resp->dataSize): 0
Failed to addStateInfo for: 1063, Result was: 4
▒HpI6▒▒▒▒yɨ▒▒x`▒^E▒KG▒|▒$Connecting to XXXXXX
WiFi connected, IP isXXXXXXAbout to request buffer
Requesting a buffer of : 4608 bytes
_bufferSize: 4608,

_maxPayload (Including null terminator): 4096
About To Try: 115200
Timed Out (inByteNumZeroIndexed): 7
Timed Out (gotSlaveID): 1
Timed Out (gotFunctionCode): 1
Timed Out (resp->functionCode): 3
Timed Out (gotData): 1
Timed Out (resp->dataSize): 2
Timeout waiting for RS485 response.  Likely no more data coming.
Timed Out (inByteNumZeroIndexed): 0
Timed Out (gotSlaveID): 0
Timed Out (gotFunctionCode): 0
Timed Out (resp->functionCode): 0
Timed Out (gotData): 0
Timed Out (resp->dataSize): 0
Attempting MQTT connection...Connected MQTT
Timeout waiting for RS485 response.  Likely no more data coming.
Timed Out (inByteNumZeroIndexed): 0
Timed Out (gotSlaveID): 0
Timed Out (gotFunctionCode): 0
Timed Out (resp->functionCode): 0
Timed Out (gotData): 0
Timed Out (resp->dataSize): 0
noResponse
Timeout waiting for RS485 response.  Likely no more data coming.
Timed Out (inByteNumZeroIndexed): 0
Timed Out (gotSlaveID): 0
Timed Out (gotFunctionCode): 0
Timed Out (resp->functionCode): 0
Timed Out (gotData): 0
Timed Out (resp->dataSize): 0
Failed to addStateInfo for: 258, Result was: 4
Timed Out (inByteNumZeroIndexed): 7
Timed Out (gotSlaveID): 1
Timed Out (gotFunctionCode): 1
Timed Out (resp->functionCode): 3
Timed Out (gotData): 1
Timed Out (resp->dataSize): 2
Timed Out (inByteNumZeroIndexed): 7
Timed Out (gotSlaveID): 1
Timed Out (gotFunctionCode): 1
Timed Out (resp->functionCode): 3
Timed Out (gotData): 1
Timed Out (resp->dataSize): 2
Timed Out (inByteNumZeroIndexed): 7
Timed Out (gotSlaveID): 1
Timed Out (gotFunctionCode): 1
Timed Out (resp->functionCode): 3
Timed Out (gotData): 1
Timed Out (resp->dataSize): 2
Timed Out (inByteNumZeroIndexed): 7
Timed Out (gotSlaveID): 1
Timed Out (gotFunctionCode): 1
Timed Out (resp->functionCode): 3
Timed Out (gotData): 1
Timed Out (resp->dataSize): 2
Timed Out (inByteNumZeroIndexed): 9
Timed Out (gotSlaveID): 1
Timed Out (gotFunctionCode): 1
Timed Out (resp->functionCode): 3
Timed Out (gotData): 1
Timed Out (resp->dataSize): 4
Timed Out (inByteNumZeroIndexed): 9
Timed Out (gotSlaveID): 1
Timed Out (gotFunctionCode): 1
Timed Out (resp->functionCode): 3
Timed Out (gotData): 1
Timed Out (resp->dataSize): 4
Timed Out (inByteNumZeroIndexed): 7
Timed Out (gotSlaveID): 1
Timed Out (gotFunctionCode): 1
Timed Out (resp->functionCode): 3
Timed Out (gotData): 1
Timed Out (resp->dataSize): 2
Timed Out (inByteNumZeroIndexed): 9
Timed Out (gotSlaveID): 1
Timed Out (gotFunctionCode): 1
Timed Out (resp->functionCode): 3
Timed Out (gotData): 1
Timed Out (resp->dataSize): 4
Timed Out (inByteNumZeroIndexed): 7
Timed Out (gotSlaveID): 1
Timed Out (gotFunctionCode): 1
Timed Out (resp->functionCode): 3
Timed Out (gotData): 1
Timed Out (resp->dataSize): 2
Timed Out (inByteNumZeroIndexed): 9
Timed Out (gotSlaveID): 1
Timed Out (gotFunctionCode): 1
Timed Out (resp->functionCode): 3
Timed Out (gotData): 1
Timed Out (resp->dataSize): 4
Timeout waiting for RS485 response.  Likely no more data coming.
Timed Out (inByteNumZeroIndexed): 0
Timed Out (gotSlaveID): 0
Timed Out (gotFunctionCode): 0
Timed Out (resp->functionCode): 0
Timed Out (gotData): 0
Timed Out (resp->dataSize): 0
Failed to addStateInfo for: 1077, Result was: 4
Timeout waiting for RS485 response.  Likely no more data coming.
Timed Out (inByteNumZeroIndexed): 0
Timed Out (gotSlaveID): 0
Timed Out (gotFunctionCode): 0
Timed Out (resp->functionCode): 0
Timed Out (gotData): 0
Timed Out (resp->dataSize): 0
Failed to addStateInfo for: 65534, Result was: 4
Timeout waiting for RS485 response.  Likely no more data coming.
Timed Out (inByteNumZeroIndexed): 0
Timed Out (gotSlaveID): 0
Timed Out (gotFunctionCode): 0
Timed Out (resp->functionCode): 0
Timed Out (gotData): 0
Timed Out (resp->dataSize): 0
```

dxoverdy, 2023-10-04:
This other gent I’ve been talking to swapped over to an ESP32 which could
use hardware serial and could *possibly* result in a better experience.
 115200 is fast for the amount of data being requested in quick succession.

That said, alpha support told him he should write 0 to 0x810 in order to
swap the baud rate to 9600 which would put you in line with everyone else
and should give a more reliable connection.  Obviously Alpha2MQTT has
inbuilt functionality to do this with a single ping… but he wasn’t brave
enough.

I would swap it to 9600 but I can’t make you.  If you would like to have a
chat with the guy his email is

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

dxoverdy, 2023-10-04:
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

dxoverdy, 2023-10-04:
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

ffrog8, 2023-10-05:
Thanks. I'll reach out. In the mean time I tried a bit of this.

```
/request/read/register/handled
{
    "registerAddress": "0x0810",
    "dataBytes": 2
}
```

and got  (eventually after many attempts)

```
Alpha2MQTT/response/read/register/handled
{
    "responseStatus": "readDataRegisterSuccess",
    "registerAddress": "0x0810",
    "functionCode": 3,
    "registerName": "REG_SYSTEM_CONFIG_RW_MODBUS_BAUD_RATE",
    "dataType": "unsignedShort",
    "dataValue": 1,
    "formattedDataValue": "115200 (Only household)",
    "rawDataSize": 2,
    "rawData": [0,1],
    "end": "true"
}
```

Stacks up. So I figured no harm in trying to writing 1 back again?

```
/request/write/register/raw/data
{
    "registerAddress": "0x0810",
    "dataBytes": 2,
    "value": 1
}
```

Again - many many publishes later

```
Alpha2MQTT/response/write/register/raw/data
{
    "responseStatus": "writeDataRegisterSuccess",
    "registerAddress": "0x0810",
    "functionCode": 16,
    "rawDataSize": 4,
    "rawData": [8,16,0,1],
    "end": "true"
}
```

Followed by a read back

```
{
    "responseStatus": "readDataRegisterSuccess",
    "registerAddress": "0x0810",
    "functionCode": 3,
    "registerName": "REG_SYSTEM_CONFIG_RW_MODBUS_BAUD_RATE",
    "dataType": "unsignedShort",
    "dataValue": 1,
    "formattedDataValue": "115200 (Only household)",
    "rawDataSize": 2,
    "rawData": [0,1],
    "end": "true"
}
```

What i'm not sure about is how i'll know the baud rate has been changed? Does it take affect immediately? Do i need to power cycle the battery/inverter? If it does happen immediately how will i tell the difference between a noResponse that i'm getting most of the time now vs a noResponse because the baud rate has changed and Alpha2MQTT is still using the old baud rate?

dxoverdy, 2023-10-05:
/request/write/register/raw/data
{
    "registerAddress": "0x0810",
    "dataBytes": 2,
    "value": 1
}

You need to write the value 0 to swap to 9600.  Burning 1 just leaves it at
115200 as per the screenshot spec above :)

Once swapped to 9600 in theory comms will stop immediately and you’d need
to reboot your Alpha2MQTT to connect back in at 9600.  But the device may
require a reboot for it to take affect

Dan

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

ffrog8, 2023-10-05:
Yeah I was too chicken shit to try changing the value to 9600 on the write first attempt. Seems like I'll have to suck it and see.

dxoverdy, 2023-10-05:
LOL

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

ffrog8, 2023-10-06:
So i puckered up and tried

```
/request/write/register/raw/data

{
  "registerAddress": "0x0810",
  "dataBytes": 2,
  "value": 0
}
```

Multiple times because i don't actually know what to expect. I did get a reply

```
{
    "responseStatus": "writeDataRegisterSuccess",
    "registerAddress": "0x0810",
    "functionCode": 16,
    "rawDataSize": 4,
    "rawData": [8,16,0,1],
    "end": "true"
}
```

I get the impression that the raw data should be 8, 16, 0 ,0 ?
I was eventually able to read back the baud register

```
{
    "responseStatus": "readDataRegisterSuccess",
    "registerAddress": "0x0810",
    "functionCode": 3,
    "registerName": "REG_SYSTEM_CONFIG_RW_MODBUS_BAUD_RATE",
    "dataType": "unsignedShort",
    "dataValue": 1,
    "formattedDataValue": "115200 (Only household)",
    "rawDataSize": 2,
    "rawData": [0,1],
    "end": "true"
}
```

I rebooted the Alpha2MQTT - still reported 115200 as baud rate
I rebooted inverter Alpha2MQTT again reported 115200 as baud rate

So i'm kinda stummped again?

ffrog8, 2023-10-06:
Good ideas, I'll give them a try.

ffrog8, 2023-10-06:
So I tried the force charge/discharge write. No joy. Then sitting back and thinking for a bit started wondering about library versions. I build things a little differently. TL;DR turns out I'm using esp8266 core 3.1.2 instead of 3.0.2. :facepalm: Now it works great* at the 115200 baud rate!

I use a docker container and arduino-cli to build because reasons, I didn't want to install another ide, I have two alphas and need two firmware's with different device names.

the build script looks like this.
the entrypoint tail -f is just to keep the container running so multiple builds can be done without having to reinstall all the libs into the container each time

```
#!/bin/bash
#  export GIT_BASE=/volume1/docker_cached/apps/vscode/git/Alpha2MQTT
#  docker run -d --name arduino-cli-build -v  ${GIT_BASE}:/project --entrypoint tail solarbotics/arduino-cli:0.25.0-python3.7 -f /dev/null
#  docker exec -it arduino-cli-build /project/Alpha2MQTT/build.sh

arduino-cli core update-index --additional-urls https://arduino.esp8266.com/stable/package_esp8266com_index.json
arduino-cli core install esp8266:esp8266@3.0.2  --additional-urls https://arduino.esp8266.com/stable/package_esp8266com_index.json
arduino-cli lib install "Adafruit BusIO"
arduino-cli lib install "Adafruit SSD1306"
arduino-cli lib install "Adafruit GFX Library"
arduino-cli lib install PubSubClient

cd /project
for SER in 01 02
do
    echo "Building for ${SER}"
    arduino-cli  compile -e --build-property build.extra_flags="-DESP8266  -DDEVICE_NAME=\"Alpha2MQTT-${SER}\"" --fqbn esp8266:esp8266:nodemcuv2 Alpha2MQTT
    mv Alpha2MQTT/build/esp8266.esp8266.nodemcuv2/Alpha2MQTT.ino.bin ./Alpha2MQTT-${SER}.bin
done
```

producing an output like this
```
Building for 01
Executable segment sizes:
ICACHE : 32768           - flash instruction cache
IROM   : 314144          - code in flash         (default or ICACHE_FLASH_ATTR)
IRAM   : 29477   / 32768 - code in IRAM          (IRAM_ATTR, ISRs...)
DATA   : 1512  )         - initialized variables (global, static) in RAM/HEAP
RODATA : 16404 ) / 81920 - constants             (global, static) in RAM/HEAP
BSS    : 26848 )         - zeroed variables      (global, static) in RAM/HEAP
Sketch uses 361537 bytes (34%) of program storage space. Maximum is 1044464 bytes.
Global variables use 44764 bytes (54%) of dynamic memory, leaving 37156 bytes for local variables. Maximum is 81920 bytes.

Used library         Version Path
SoftwareSerial       6.12.7  /home/circleci/.arduino15/packages/esp8266/hardware/esp8266/3.0.2/libraries/SoftwareSerial
ESP8266WiFi          1.0     /home/circleci/.arduino15/packages/esp8266/hardware/esp8266/3.0.2/libraries/ESP8266WiFi
PubSubClient         2.8     /home/circleci/Arduino/libraries/PubSubClient
SPI                  1.0     /home/circleci/.arduino15/packages/esp8266/hardware/esp8266/3.0.2/libraries/SPI
Wire                 1.0     /home/circleci/.arduino15/packages/esp8266/hardware/esp8266/3.0.2/libraries/Wire
Adafruit_GFX_Library 1.11.7  /home/circleci/Arduino/libraries/Adafruit_GFX_Library
Adafruit_BusIO       1.14.1  /home/circleci/Arduino/libraries/Adafruit_BusIO
Adafruit_SSD1306     2.5.7   /home/circleci/Arduino/libraries/Adafruit_SSD1306

Used platform   Version Path
esp8266:esp8266 3.0.2   /home/circleci/.arduino15/packages/esp8266/hardware/esp8266/3.0.2
```

\* sometimes the REG_CUSTOM load & solar are missing from the 10sec state.

Spookster, 2023-10-06:
It seems to be a similar issue to what I experienced. Im curious as to why restarting the esp reestablishes the data connection.
Is there a handshake involved? Why would the data not restart?

```
14:57:01.349 -> Timed Out (gotData): 0
14:57:01.349 -> Timed Out (resp->dataSize): 0
14:57:01.395 -> Rx: Nothing
14:57:01.395 -> noResponse
14:57:04.769 -> Tx: 55 03 01 02 00 01 29 E2
14:57:05.185 -> Timeout waiting for RS485 response.  Likely no more data coming.
14:57:05.252 -> Timed Out (inByteNumZeroIndexed): 0
14:57:05.285 -> Timed Out (gotSlaveID): 0
14:57:05.318 -> Timed Out (gotFunctionCode): 0
14:57:05.352 -> Timed Out (resp->functionCode): 0
14:57:05.385 -> Timed Out (gotData): 0
14:57:05.385 -> Timed Out (resp->dataSize): 0
14:57:05.418 -> Rx: Nothing
14:57:05.451 -> Failed to addStateInfo for: 258, Result was: 4
14:57:05.493 -> Tx: 55 03 01 26 00 01 69 E9
14:57:05.818 -> Timeout waiting for RS485 response.  Likely no more data coming.
14:57:05.886 -> Timed Out (inByteNumZeroIndexed): 0
14:57:05.933 -> Timed Out (gotSlaveID): 0
14:57:05.966 -> Timed Out (gotFunctionCode): 0
14:57:06.000 -> Timed Out (resp->functionCode): 0
14:57:06.033 -> Timed Out (gotData): 0
14:57:06.033 -> Timed Out (resp->dataSize): 0
14:57:06.067 -> Rx: Nothing
```

ffrog8, 2023-10-06:
Restarting Alpha2MQTT ESP would put it back into its loop to find the correct baud rate?  Does yours reestablish after a restart? I recall seeing a FORCE_RESTART in the code maybe that could help.

Spookster, 2023-10-06:
During trouble shooting, I tried :

```
#define FORCE_RESTART
#define FORCE_RESTART_HOURS 1
```

Assuming it did actually force a restart ( I didnt monitor it) then no, it didnt reestablish a connection

ffrog8, 2023-10-07:
Think you've probably got more experience than I running Alpha2MQTT -
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

Thread 19 (2023-10-12):

Other hardware

vantech14, 2023-10-12:
Hi,

Is there a known "ready to use" device available that can connect via 485 into my B3?

I'd rather use a factory made device if I can.

Contacted alpha recently and when I (eventually) got a reply, they confirm Mobus TCP isn't possible.

Thanks.

dxoverdy, 2023-10-12:
I’m rocking a B3 too, for what it’s worth.
It’s functional but you can sorta tell Alpha have moved on and aren’t
taking older kit with them.

A bit like Samsung really.

It’s a shame as I’d have loved the opportunity to build a robust
development for modbus tcp.

Dan

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

vantech14, 2023-11-10:
@dxoverdy do you happen to know the Modbus slave address / ID for your b3 inverter? I have tried 85 and no luck!

Thanks.

dxoverdy, 2023-11-11:
The default of 0x55 worked for me and 100% of other folk I know of.

I’d be looking elsewhere for faults to be honest.
Regards
Dan

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

vantech14, 2023-11-11:
@dxoverdy I've got it working. I am however struggling to find the correct registers for the following:

Consumption in watts (total load for the house in watts) - is this the value of the battery + grid + solar combined?

Grid and solar total energy consumed / exported?

Battery load (charging vs discharging)

Any ideas / hints? Thanks.

dxoverdy, 2023-11-11:
Those are exposed in the ten second schedule

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

vantech14, 2023-11-18:
@dxoverdy i am trying to write the target SOC using node red. I'm running home assistant so trying to manage the full integration there for obvious reasons.

Totally outside of this project, but would appreciate some help.

I am trying to write a value to the target SOC register 2133 (this same register reports back the current SOC which I've proven by updating the app). It doesn't however respond to any write commands,and neither does any of the time control registers.

Any ideas? Appreciate any input as this is driving me up the wall ;-)

Thanks.

Closed 2023-11-18.

Thread 20 (2024-01-04):

Smile G3-S5

ettiennecoetzee, 2024-01-04:
Tried this installation on this inverter setup without success.
The inverter documentation does not include details regarding the RS485 pinout. I did what the author did and measured on all the twisted pairs to see if I can get a stable DC voltage, but couldn't find any. I hooked it up to the device using the pinout described in the notes, but no luck. Then tried all the different inverter setups, still no luck. If anybody has this specific inverter working with Alpha2MQTT, please let me know how you made it work. Thanks! Great instructions though!

dxoverdy, 2024-01-04:
Which inverter are you running and from which year?

Thanks

On Thu, 4 Jan 2024 at 18:04, Ettienne Coetzee ***@***.***>
wrote:

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

dxoverdy, 2024-01-04:
Ah it’s a g3-s5.  Sorry, reading on email.

Can you send a photograph of the rj45 ports?

It is likely to be 4B/5A (Blue and white B, Green A) as they all tend to
use that.

On Thu, 4 Jan 2024 at 18:04, Ettienne Coetzee ***@***.***>
wrote:

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

ettiennecoetzee, 2024-01-04:
My apologies, I wired the ESP32 pins incorrectly. Had a quick resolder job and its now working fine! I used the following RJ45 pinout (T568B layout):  Blue to B and Blue/white to A. Configured as the Smile B3. Thanks for the great instructions (I just didn't read them properly :)

dxoverdy, 2024-01-05:
Amazing outcome :)  Enjoy.  Be sure to send any pics in action or share any developments you get up to!

ettiennecoetzee, 2024-01-06:
I know this is a closed issue, but I just wanted to know if I can draw 5V DC from anywhere obvious in the inverter setup to power this nifty device?

dxoverdy, 2024-01-06:
I’ve been think about this for ages and I need to investigate.  I don’t run
my own alpha2mqtt believe it or not due to this… would be great to leach a
5V source.  Or even if there is a 12V and just use a step down buck
converter to get it to 5V.

I’ll take the case off and have a look later.

On Sat, 6 Jan 2024 at 12:12, Ettienne Coetzee ***@***.***>
wrote:

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

ettiennecoetzee, 2024-01-06:
Just want to mention: the effort that has gone into this must have been enormous! Just the node red code pred alone must have been massive work! Many thanks for all this!

Closed 2024-01-05.

Thread 21 (2024-02-04):

Limit spurious data spikes on Load and Solar sensors.

PhilipCraigAU, 2024-02-04:
G'day Is it possible to set voltage limits on the power sensors. For example if you have 10kW solar inverter it will never exceed say 10,100 watts. Sometimes when I restart my battery I get weird voltage spikes of 100,000 watts + being recorded, which throws out the graphs. Alpha load for house is the same,where the maximum load would never exceed about 11,000 watts in a worse case scenario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. Screenshots attached 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
Thanks

dc42, 2024-02-05:
I presume you are running the latest version of the ESP software with the CRC issue fixed. I saw a lot of spikes in the data before I fixed that issue. Now I still see occasional spikes in the data. I plan to add some limit checking to the ESP code to ignore readings that are out of range. Alternatively, limit checking could be added to the NodeRed code in the Home Assistant integration.

PhilipCraigAU, 2024-02-06:
Thanks for the prompt reply Daniel.
The spikes are only occasional, but it only takes one to throw the charts out.
I have used the SQLite Web add on and run the following queries to clean up the spikes:-

BOOKMARKS for QUERY

1. delete load > 10,000
DELETE FROM "states" WHERE (attributes_id = 9) AND (state LIKE '_____%')
(ALPHA-LOAD REMOVES POSITIVE VALUES above 10,000)

2. delete load > 100,000
DELETE FROM "states" WHERE (attributes_id = 9) AND (state LIKE '______%')
(ALPHA-LOAD REMOVES POSITIVE VALUES above 100,000)

3. delete SOLAR-POWER > 10,000
DELETE FROM "states" WHERE (attributes_id = 17) AND (state LIKE '_____%')
(ALPHA-SOLAR-POWER  REMOVES POSITIVE VALUES above 10,000)

I was on V1.25 and have updated to the current V1.26 and re flashed with any updates downloaded in Arduino IDE.

I had a play in the YAML sensor file to try and modify the value template (which gives the correct result in Developer\templates testing area, but it errors in Alpha2MQTT   I couldn't work out where in the NodeRed file should I be looking

    - device_class: "power"
      state_class: "measurement"
      force_update: "true"
      icon: "mdi:solar-power"
      name: "Alpha Solar Power"
      unique_id: "alpha_solar_power"
      unit_of_measurement: "W"
      state_topic: "HomeAssistant/MQTTSensor/REG_CUSTOM_TOTAL_SOLAR_POWER"
    # value_template: "{% if states('sensor.alpha_solar_power') | int <10100 %}{{ value | int ) }}{% else %}{% endif %}}"
      value_template: "{{ value | int }}"
    #  #correct result in Developer\Templates test - but not working here

Greetings from Australia

jacobcurulli, 2024-02-28:
Hi @PhilipCraigAU, did you resolve this issue? I'm seeing the same spikes.

PhilipCraigAU, 2024-03-04:
@jacobcurulli   No it's still unresolved.  I'm just running the SQLite queries to clean it up.  Note: you have to go into the history to see the clean result.  The short term displays the spike annoyingly.

dc42, 2024-03-04:
Which values are showing spikes, and for those values what is a reasonable limit above which the reading should be treated as suspicious?

PhilipCraigAU, 2024-03-05:
G'day Daniel
This relates to Australia if it makes any difference  (Voltage is 240v)
Ideally these parameters could be set in **definitions.h** by the user so they could be finessed, or allow for users with higher demands. Otherwise below is probably around the mark.

**sensor.alpha_load**   (House load)  would be unlikely to exceed 15,000w
So spikes above 15,000 (or user defined - should be ignored)
eg. house base load 500w, aircon flat out 6000w, oven 3500w + 5000w overhead available for additional grid demand.
My grid demand has never exceeded 9.6kWh

**sensor.alpha_solar_power** (Solar generation)  would be unlikely to exceed 15,000w
So spikes above 15,000 (or user defined - should be ignored)
eg. the inverters on the Alpha-ESS are typically 5,000w in DC / hybrid mode - Plus any stand alone solar inverters such as mine which are 10,000w.   My maximum solar generation is 10,000w as my battery is AC coupled
In South Australia households are limited to 5kWh grid export on Single Phase & 15kWh on 3 Phase

Hope this helps. I can send some additional graphs if you require them, and I'm happy to supply further information or be involved in help testing the code.
Kind Regards
Phil

dxoverdy, 2024-04-29:
If you are running the latest version of the code and receiving spikes, then there's something a a little strange going on, because you are getting a large reading AND passing the CRC check.

To get rid of them, I wouldn't go coding it on the chip, instead, amend your Node Red flow to introduce checks with the Switch nodes.  Switch nodes are the equivalent of 'IF' statements, allowing you to ask of a payload or other value, "IF X then output via channel 1, IF Y then output via channel 2"  In the case of what we want to do here, all we need for battery SOC for example is  a single channel output which tests if msg.payload between 0 and 100.  As channel 1 is the only output we connect that to the MQTT output.  If there is a spurious figure outside 0 and 100 it will just be disregarded.  Alternatively you could introduce a channel 2 which sends the message to another MQTT topic where you can log errors.

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

PhilipCraigAU, 2024-05-06:
Thanks Daniel,
You gave me enough information to work out what to do, and so far it appears to be working. Thank you so much :)

For those playing at home, here are the screenshots of the modifications to the Node Red flows.  Essentially drag the "SWITCH" function between the REG & Send_REG flow, edit with your desired range for maximum house loads and solar inverter production, and rename as desired.  Don't forget to deploy.
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

Closed 2024-05-07.

Thread 22 (2024-04-09):

Access to 30 and 15 minute charge / discharge time registers

spiderdijon, 2024-04-09:
Later version of the Alpha ESS inverters (all of them?) firmware allows the smart phone app to set schedules with 15 minutes intervals. The modbus registers (0x0851 - 0x0859) seem to be fixed at 1H/bit. I can see these registers changing hour when a time is set in the app but I can't seem to find out where the 15/30 minutes is saved. Does anyone know the correct register assuming they exist?

spiderdijon, 2024-04-09:
Apologies. I have just seen this discussion here https://github.com/dxoverdy/Alpha2MQTT/issues/8

Closed 2024-04-09.

Thread 24 (2024-04-14):

ESP32 UART Issue

DannyBoy-PI, 2024-04-14:
Just an FYI - The code for ESP32 has been updated (See link: https://github.com/espressif/arduino-esp32/issues/9500)

This causes the UART (hardware serial 2 to fail !)

Workaround is to change the following line in RS485Handler.cpp (line 33) until they fix it:

FROM: 	_RS485Serial->begin(DEFAULT_BAUD_RATE, SERIAL_8N1);

TO: 	_RS485Serial->begin(DEFAULT_BAUD_RATE, SERIAL_8N1, 16, 17);

This gave me a two hour headache to find the cause after updating the Alpha2MQTT software.....

Dan M.

Thread 25 (2024-05-06):

Battery self discharge

spiderdijon, 2024-05-06:
I'm not sure if there is a better place to discuss this than the issues section? Under normal conditions, it seems the battery (smile B3) registers a discharge of around 36W when it's neither charging or discharging. This does seem to cause the SoC to drop gradually. I have discovered that if I write 0 to REG_BATTERY_HOME_RW_BATTERY_MOS_CONTROL the battery status changes to "idle" and the discharge drops to 0W. However, shortly after within a few seconds it returns to around 36W and REG_BATTERY_HOME_RW_BATTERY_MOS_CONTROL has been set to 1 again automatically. Has anyone had experience in using the MOS_CONTROL register to force the battery into IDLE mode? I would like to reduce the unnecessary discharge when the battery is intended to not be doing anything.

PhilipCraigAU, 2024-05-07:
Think this is normal as the battery would supply standby / monitoring power to the Battery Management System. Mine shows about 20w in idle mode (S5)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

PhilipCraigAU, 2024-05-07:
Join the Alpha ESS group on facebook. Probably the best place to ask questions

https://www.facebook.com/share/zqPX5ktSyrtxRdTJ/?mibextid=K35XfP

spiderdijon, 2024-05-10:
Thanks. I unfortunately don't have a facebook account. However, to update here I can send the REG_BATTERY_HOME_RW_BATTERY_MOS_CONTROL command every 2 seconds which does keep the battery disconnected from the inverter. The power draw does drop to 0W. Once I stop spamming the command, the system reconnects everything as normal. I'm hoping to stop the battery periodically charging its self through the night as it reaches it's minimum SoC. Normally if I stop discharging at 10% at night, by the morning it's at ~3% and the logs show periodic 2500W charging spikes for several hours prior. I'm hoping to stop charging at say 5%, disconnect the battery using the MOS command (which also has the benefit of turning the fan off) and then in the morning or just prior to a scheduled charge, stop sending the MOS command and reconnect the battery. This should avoid energy being wasted.

What I was hoping to find out originally was which mechanism was automatically reconnecting the battery. I tried disconnecting it from the internet to see if it was a command from Alpha servers, but it was not. However, spamming the command seems like a workaround. I'll test more.

dxoverdy, 2024-05-16:
I don't think anyone in the world could advocate you bamming the system MOS control.

I'll be honest, I don't fully understand your scenario.  If it's neither charging nor discharging, it must be servicing your minimal house load of some sorts.  A house is very rarely dead to the grid, even an LED on your router is going to need servicing.

It sounds to me all you need to use is the inbuilt discharge period control on AlphaCloud or the app, which disables the battery from servicing loads between specific times of the day.  Or, you can use dispatch to put the device into mode 1 for an hour and see if that does what you expect.

If you are attempting the last option, send the following commands to
Alpha2MQTT/request/write/register/raw/data

Start Dispatch:
{"registerAddress": "0x0880","value":1,"dataBytes":2}

Dispatch Time
{"registerAddress": "0x0887","value":600,"dataBytes":4}

Dispatch Mode 1 (Battery only charged via PV):
{"registerAddress": "0x0885","value":1,"dataBytes":2}

That should disable the battery for 5 minutes (600 seconds) (by saying it will only accept charge via PV, rather than servicing loads) before going back to normal usage.  If it works as expected, you can extend the number of seconds to suit.

You can come out of dispatch mode at any time by sending
{"registerAddress": "0x0880","value":0,"dataBytes":2}

dxoverdy, 2024-05-27:
Also note that the system is powered by the battery on the DC side, not the AC side, and the unit requires power to operate which may be the small draw you are seeing.  Alpha 'fiddle' this by not showing any figures in the app < 80W or so which is why you may be wondering why Alpha2MQTT shows legitimate draw and the app shows nothing.  I verified this by looking at my Growatt app early in the morning when solar had just turned on.  It was showing generation of around 50W, Alpha2MQTT was reporting similar, but the app was at zero.

You may be asking "why is it not powered from the gird" - but it's a system can work off-grid and so has to be designed such that everything can work should the grid be unavailable... and all the circuitry is essentially DC anyway.

spiderdijon, 2024-05-27:
Yes it certainly doesn't feel right to spam the MOS control. My issue is that I frequently have times where I don't want to discharge from the battery when it is charged for example when the price of my electric drops very low. When the import rate drops below my export rate it makes sense to stop the battery servicing the loads. So I command it to not discharge which works fine but I'm dropping a reasonable number of percent every hour as the system is drawing directly from the battery. I know I won't be using the battery for X hours yet there seems to not be a mode to put it into a deep sleep. Its just a slight annoyance is all. I recognise the money that would be saved is pennies

Thread 30 (2024-09-10):

Random incorrect data

mercurystorm, 2024-09-10:
I am noticing I am getting very random data occasionally which is making my home assistant stats very wrong

Here are some examples:

2024-09-10 07:37:58 - Alpha2MQTT/state/second/ten: {^M
    "REG_BATTERY_HOME_R_SOC": 85.20,^M
    "REG_BATTERY_HOME_R_CURRENT": 13.20,^M
    "REG_INVERTER_HOME_R_CURRENT_L1": 3.00,^M
    "REG_INVERTER_HOME_R_POWER_L1_1": 414253056,^M
    "REG_DISPATCH_RW_DISPATCH_MODE": "Unknown",^M
    "REG_DISPATCH_RW_ACTIVE_POWER_1": -1509949440,^M
    "REG_DISPATCH_RW_DISPATCH_SOC": 2576980378,^M
    "REG_DISPATCH_RW_DISPATCH_TIME_1": 25000,^M
    "REG_INVERTER_HOME_R_PV1_POWER_1": 0,^M
    "REG_INVERTER_HOME_R_PV3_POWER_1": 0,^M
    "REG_INVERTER_HOME_R_PV4_POWER_1": 0,^M
    "REG_INVERTER_HOME_R_PV5_POWER_1": 0,^M
    "REG_INVERTER_HOME_R_PV6_POWER_1": 0,^M
    "REG_CUSTOM_TOTAL_SOLAR_POWER": 122868^M

2024-09-10 07:38:09 - Alpha2MQTT/state/second/ten: {^M
    "REG_BATTERY_HOME_R_SOC": 3276.80,^M
    "REG_INVERTER_HOME_R_CURRENT_L1": 3.00,^M
    "REG_INVERTER_HOME_R_POWER_L1_1": 645,^M
    "REG_INVERTER_HOME_R_INVERTER_TEMP": 3.70,^M
    "REG_DISPATCH_RW_DISPATCH_START": "Stop",^M
    "REG_DISPATCH_RW_ACTIVE_POWER_1": 32000,^M
    "REG_DISPATCH_RW_DISPATCH_TIME_1": 25000,^M
    "REG_INVERTER_HOME_R_PV1_POWER_1": 0,^M
    "REG_INVERTER_HOME_R_PV2_POWER_1": 4278190080,^M
    "REG_INVERTER_HOME_R_PV3_POWER_1": 1308622848,^M
    "REG_INVERTER_HOME_R_PV4_POWER_1": 61430,^M

2024-09-10 08:03:41 - Alpha2MQTT/state/second/ten: {^M
    "REG_INVERTER_HOME_R_CURRENT_L1": 2.40,^M
    "REG_INVERTER_HOME_R_POWER_L1_1": 461,^M
    "REG_INVERTER_HOME_R_INVERTER_TEMP": 3.70,^M
    "REG_DISPATCH_RW_DISPATCH_START": "Stop",^M
    "REG_DISPATCH_RW_DISPATCH_MODE": "Unknown",^M
    "REG_DISPATCH_RW_ACTIVE_POWER_1": 52902,^M
    "REG_DISPATCH_RW_DISPATCH_SOC": 0,^M
    "REG_DISPATCH_RW_DISPATCH_TIME_1": 25000,^M
    "REG_INVERTER_HOME_R_PV1_POWER_1": 36,^M
    "REG_INVERTER_HOME_R_PV2_POWER_1": 44,^M
    "REG_INVERTER_HOME_R_PV3_POWER_1": 0,^M
    "REG_INVERTER_HOME_R_PV4_POWER_1": 0,^M
    "REG_INVERTER_HOME_R_PV5_POWER_1": 0,^M
    "REG_INVERTER_HOME_R_PV6_POWER_1": 0,^M
    "REG_CUSTOM_TOTAL_SOLAR_POWER": 51591^M

Any ideas what may be causing this?

mercurystorm, 2024-10-01:
I was not! I had one of the original versions running, and as it didn't have any issues it was just left - But I have upgraded last week and replaced the ESP32 (incase it was that) and the data has now been flawless!

dxoverdy, 2024-10-01:
Happy days :)  I'll close the case, but I'm really glad it's working for you.

Thread 32 (2024-10-10):

Help

Celestefano, 2024-10-10:
Good morning, can someone help me to connect my solar inverter "AlphaESS Smile5" via "PUSR RS232 RS485 Modbus RTU" in Home Assistant? 1-Inverter enabled Modbus in slave mode 2- I am using canRs485 output taking the signal A+ blue and white wire, B- blue wire. I set the converter I think correctly (it's the first time I use it and I don't even know if it's the right model for me) I followed the guides and entered all the codes with a text editor by modifying the address to communicate inside HA but I receive no signal from the sensors. Many thanks to anyone who wants to help me.

dxoverdy, 2024-10-10:
Hi there,
Sorry, I can't assist you with it I'm afraid, I have no understanding on the PUSR RS232 RS485 device and it's well outside the scope of my project.

Just try all the baud rates (9600, 115200, 19200, 57600, 38400, 14400, 4800) and slave address of 0x55 (85) decimal.

Try and read a predictable value, such as state of charge.  it's an easy one to decipher and compare to your app.
Regards
Dan

dxoverdy, 2024-10-26:
Cannot progress further.

Closed 2024-10-26.

Thread 34 (2024-10-19):

Storion SMILE T10

dehsgr, 2024-10-19:
Hi! Can you confirm this project is working with above system? Especially writing via ModBus? I‘m struggling with it in another project and end up with a timeout writing to ModBus (FC 16/0x10).

Thanks in advance!

dxoverdy, 2024-10-26:
Yes I know of a couple of guys in Belgium who used it on a T10 to good effect.  It's all the same protocol, I'm yet to see a device which doesn't work.

dehsgr, 2024-10-27:
@dxoverdy thanks for this information. Are you aware of two T10 types? There is the older version (SMILE T10, I'm asking for) and the newer version (T10-HV-INV). The newer version uses ModBus TCP. The older one uses ModBus RTU.

Windowclaw, 2024-11-06:
@dxoverdy I confirm that for at least my older Smile T10, the register writing commands according to the Modbus TCP manual V2.2 do not work. The registers are not modified, and the T10 doesn't even send any answer, neither success nor error. I exclude a communication fault, since reading registers works flawlessly.
Therefore, it would be very interesting if the guys in Belgium used the newer T10 HV-INV model, or another firmware version of the "older" SMILE T10. The puzzling thing is that the Manual V2.2 lists the "old" T10 as one of the supported models.
Here are my T10 software versions:
BMU V1.53
LMU V2.39
ISO V1.57
WR V08(159)
WR ARM-VS V19(207)
EMS-SW-VS V1.01.95D
Maybe this helps also with the T10 support of your Alpha2MQTT solution
Thank you very much!

RolfDeL, 2024-11-06:
Hi, here one of the belgian guys.

Here you have my system config:

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

dxoverdy, 2024-11-06:
[Alpha Modbus Protocol_V1.28.pdf](https://github.com/user-attachments/files/17652869/Alpha.Modbus.Protocol_V1.28.pdf)
[AlphaESS-Handbuch_SMILET30_ModBus_RTU_V17-DE.pdf](https://github.com/user-attachments/files/17652870/AlphaESS-Handbuch_SMILET30_ModBus_RTU_V17-DE.pdf)
[AlphaESS-Handbuch_SMILET30_ModBus_RTU_V17-EN.pdf](https://github.com/user-attachments/files/17652871/AlphaESS-Handbuch_SMILET30_ModBus_RTU_V17-EN.pdf)
[AlphaESS-Handbuch_SMILET30_ModBus_RTU_V123-DE.pdf](https://github.com/user-attachments/files/17652873/AlphaESS-Handbuch_SMILET30_ModBus_RTU_V123-DE.pdf)
[AlphaESS-Handbuch_SMILET30_ModBus_RTU_V123-EN.pdf](https://github.com/user-attachments/files/17652874/AlphaESS-Handbuch_SMILET30_ModBus_RTU_V123-EN.pdf)

V1.7 is the earliest version of the protocol and addresses I've got.
Can you tell me which address you are trying to write to, with what value, and with what JSON?

Thanks

dehsgr, 2024-11-07:
@dxoverdy I'm trying to write to e.g. 0x850 ff. from v1.23 (0x712 ff. from v1.7).

dxoverdy, 2024-11-07:
You’re sending 255 right, not ff?

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

dehsgr, 2024-11-07:
@dxoverdy sorry for confusion. "ff." means "and following registers". For testing I would be lucky if setting 0x850/0x712 would work. But T10 (older version) always responds with a timeout.

Windowclaw, 2024-11-07:
A sample command leading to timeout on my system is the following hex:

55 06 08 56 00 16 e7 a0

consisting of:
55: device address
06: command write single register
0856: the address to write to
0016: the hour (22:00)
e7a0: CRC16 checksum

dxoverdy, 2024-11-07:
Write single register has never worked for me.  I implemented it “just
because the manual mentions it” but I wrote in the covering notes that it
does sweet FA for me.  Swap to data register

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

Closed 2024-10-26.

Thread 36 (2024-12-06):

Alpha Smile B3 BMS CAN bus

spiderdijon, 2024-12-06:
I have started to explore the BMS CAN bus on my Smile B3. I'm using SocketCAN with a baud rate of 250000 and have made some progress. I have noticed the cell voltages for the single 2.9KWh battery I have:

`import can
import time

bus = can.Bus(channel='can0', interface='socketcan')

while True:
    message = bus.recv()

    if (message.arbitration_id == 0x181E17F3):
        print(hex(message.arbitration_id))
        print("Cell X: " + str(((message.data[1] & 0xFF) << 8)|(message.data[2])) + " mV")
        print("Cell Y: " + str(((message.data[3] & 0xFF) << 8)|(message.data[4])) + " mV")
        print("Cell Z: " + str(((message.data[5] & 0xFF) << 8)|(message.data[6])) + " mV")
    if (message.arbitration_id == 0x182417F3):
        print(hex(message.arbitration_id))
        print("Cell 0: " + str(((message.data[1] & 0xFF) << 8)|(message.data[2])) + " mV")
        print("Cell 1: " + str(((message.data[3] & 0xFF) << 8)|(message.data[4])) + " mV")
        print("Cell 2: " + str(((message.data[5] & 0xFF) << 8)|(message.data[6])) + " mV")
    if (message.arbitration_id == 0x182517F3):
        print(hex(message.arbitration_id))
        print("Cell 3: " + str(((message.data[1] & 0xFF) << 8)|(message.data[2])) + " mV")
        print("Cell 4: " + str(((message.data[3] & 0xFF) << 8)|(message.data[4])) + " mV")
        print("Cell 5: " + str(((message.data[5] & 0xFF) << 8)|(message.data[6])) + " mV")
    if (message.arbitration_id == 0x182617F3):
        print(hex(message.arbitration_id))
        print("Cell 6: " + str(((message.data[1] & 0xFF) << 8)|(message.data[2])) + " mV")
        print("Cell 7: " + str(((message.data[3] & 0xFF) << 8)|(message.data[4])) + " mV")
        print("Cell 8: " + str(((message.data[5] & 0xFF) << 8)|(message.data[6])) + " mV")
    if (message.arbitration_id == 0x182717F3):
        print(hex(message.arbitration_id))
        print("Cell 9: " + str(((message.data[1] & 0xFF) << 8)|(message.data[2])) + " mV")
        print("Cell 10: " + str(((message.data[3] & 0xFF) << 8)|(message.data[4])) + " mV")
        print("Cell 11: " + str(((message.data[5] & 0xFF) << 8)|(message.data[6])) + " mV")
    if (message.arbitration_id == 0x182817F3):
        print(hex(message.arbitration_id))
        print("Cell 12: " + str(((message.data[1] & 0xFF) << 8)|(message.data[2])) + " mV")
        print("Cell 13: " + str(((message.data[3] & 0xFF) << 8)|(message.data[4])) + " mV")
        print("Cell 14: " + str(((message.data[5] & 0xFF) << 8)|(message.data[6])) + " mV")
    if (message.arbitration_id == 0x182917F3):
        print(hex(message.arbitration_id))
        print("Cell 15: " + str(((message.data[1] & 0xFF) << 8)|(message.data[2])) + " mV")
`
It seems the CAN bus may have additional information that is not available over the Modbus. Has anyone one else looked into this? Smile B3 batteries seem hard to acquire so I'm considering writing a BMS bridge to use readily available batteries.

Apologies again for posting it as an issue rather than discussion.

dxoverdy, 2024-12-06:
I’m going to be selling my b3 soon, and it has three additional batteries.

I’ll keep you posted.

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
