dxoverdy/Alpha2MQTT/(commit log)

2022-09-10 Updated README.md and tweaked battery power display to allow for more chars.
2022-11-23 Fixed issue with PV Powers being incorrectly multiplied by 0.1.
    [Alpha2MQTT.ino, RegisterHandler.cpp]
2023-01-02 Documentation updated with reference to Alpha Modbus and Wemos D1 Mini drivers.
2023-01-09 Please see updates in 1-16b.txt
    [configuration.yaml.txt]
2023-01-13 Please see release notes 1-18.txt
    [configuration.yaml.txt]
2023-02-17 Added 'Alpha Slave Address Finder' which will iterate every possible slave addres and report which one is active on your inverter. Useful if you changed it and your inverter doesn't have a mean of re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
    [Alpha Slave Address Finder.ino, Definitions.h]
2023-05-15 Modified configuration.yaml to include device_class: "enum" for all string based sensors to rectify an issue following a recent Home Assistant update.
    [configuration.yaml.txt]
2023-07-21 V1.21 - Added ESP32 Support.
2023-07-23 1.22 ESP32 Support enhanced for all devices. Please read instructions in 1.22.txt
2023-07-24 Fixed CRC valid issue thanks to dc42.
    [RS485Handler.cpp]
